birgerjohansson/Epi/Images/epi_face_instagram_large.png

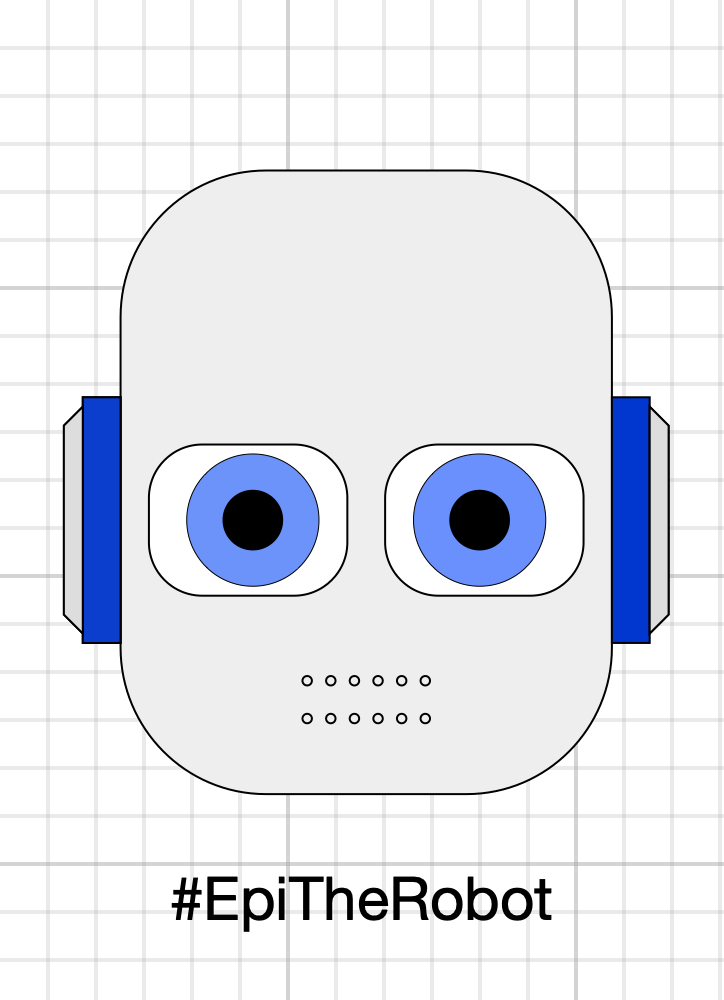
Images/epi_face_instagram_large.png
