birgerjohansson/Epi/Images/EpiArmsCrossed.jpg

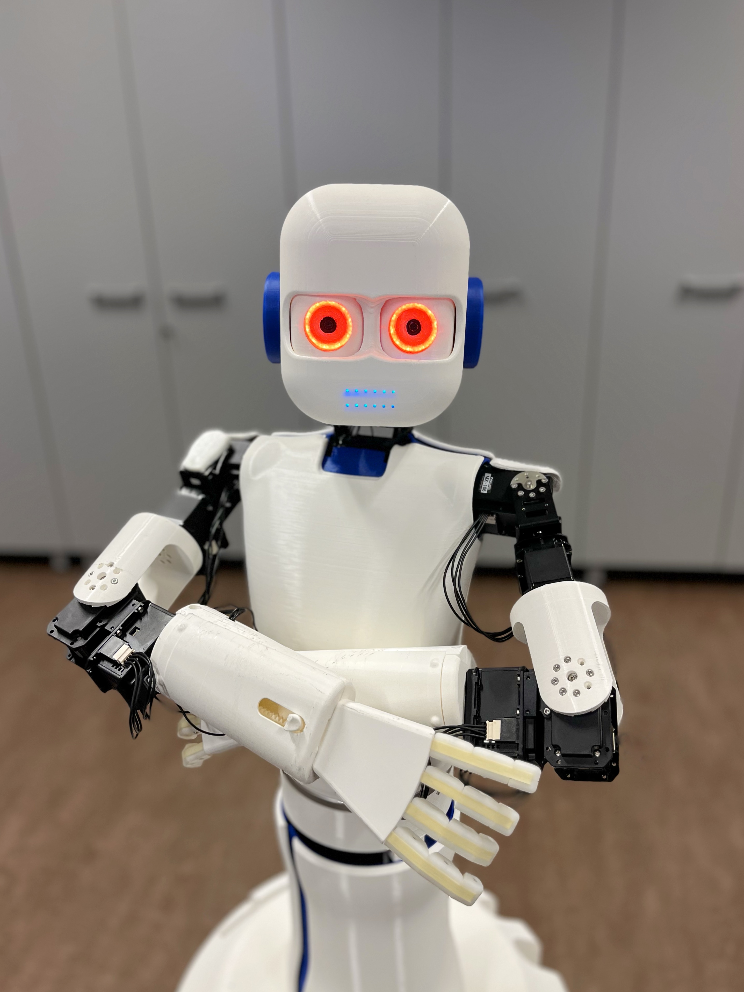
Images/EpiArmsCrossed.jpg
