birgerjohansson/Epi/Images/EpiBall.jpg

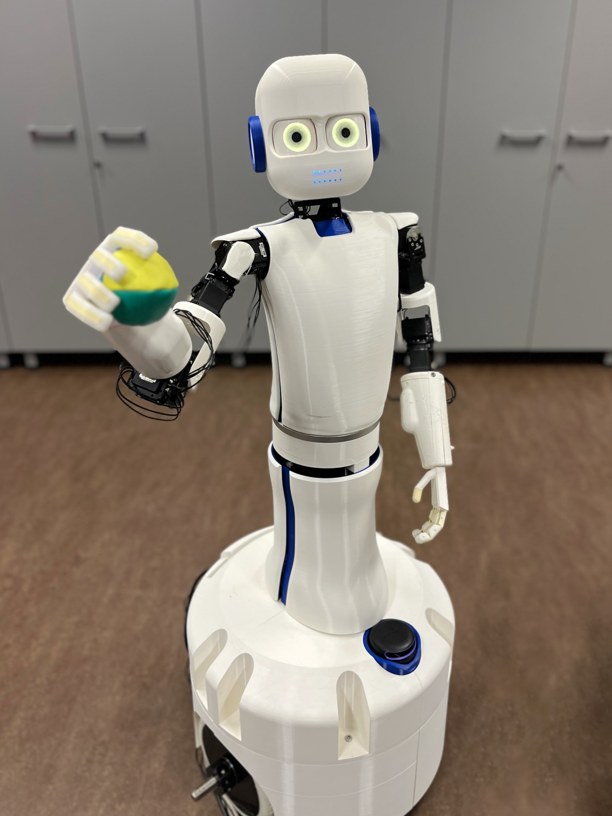
Images/EpiBall.jpg
