birgerjohansson/Epi/Images/EpiHandshake.jpg

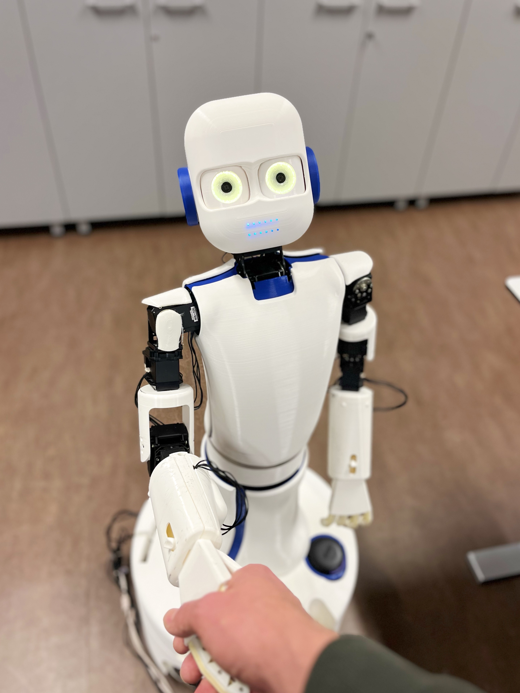
Images/EpiHandshake.jpg
