birgerjohansson/Epi/Images/EpiHoldingDuck.jpg

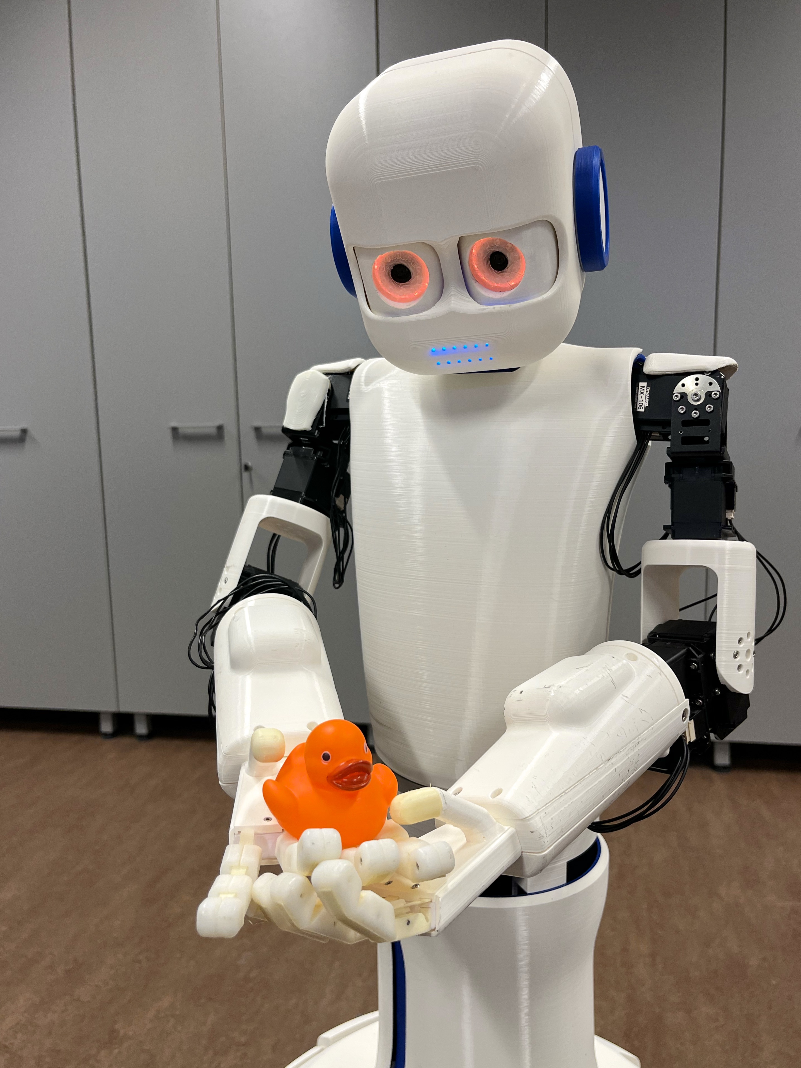
Images/EpiHoldingDuck.jpg
