birgerjohansson/Epi/Images/EpiLookingAtDuck.jpg

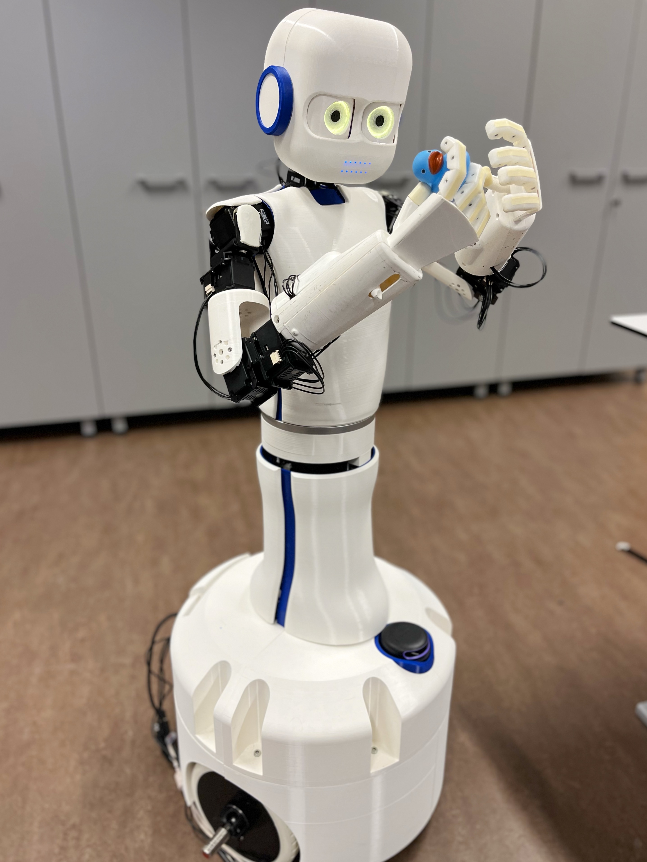
Images/EpiLookingAtDuck.jpg
