birgerjohansson/Epi/Images/EpiTorso.jpg

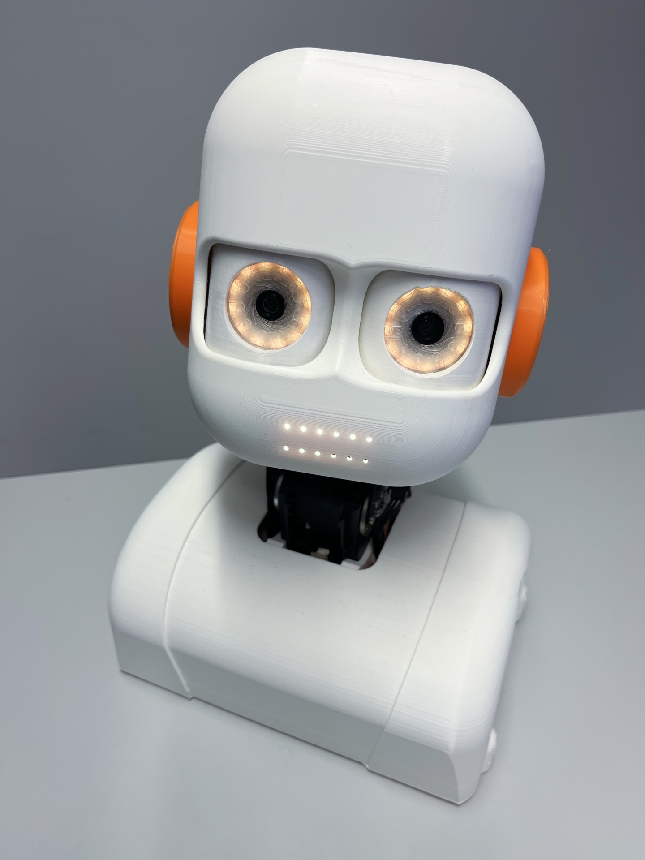
Images/EpiTorso.jpg
