birgerjohansson/Epi/Images/EpiTorso/1.jpg

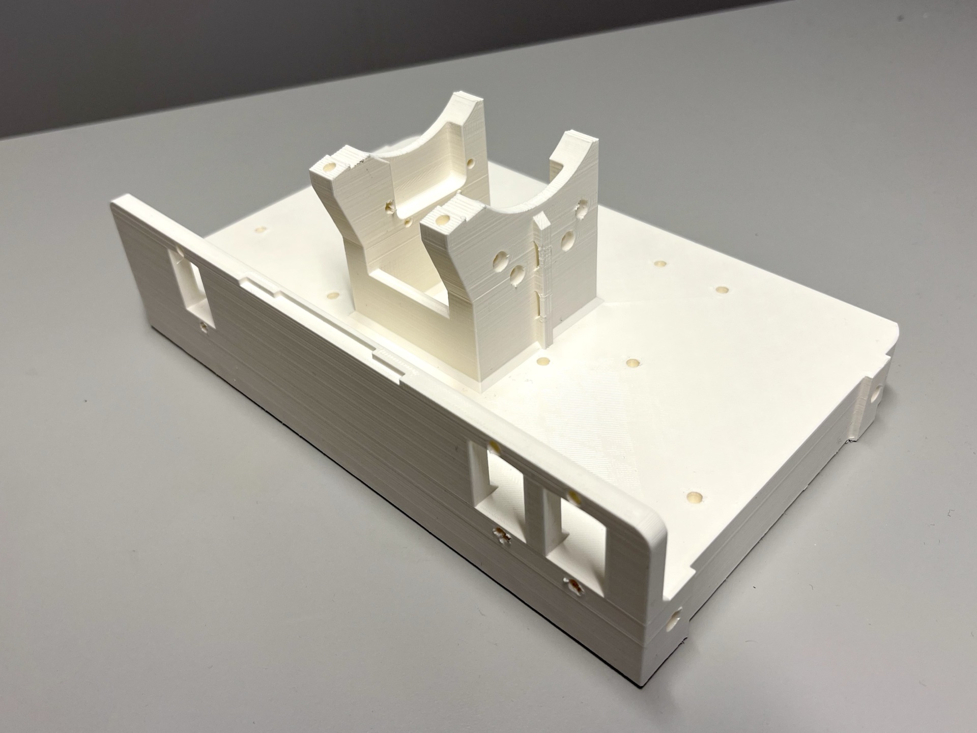
Images/EpiTorso/1.jpg
