birgerjohansson/Epi/Images/EpiTorso/2.jpg

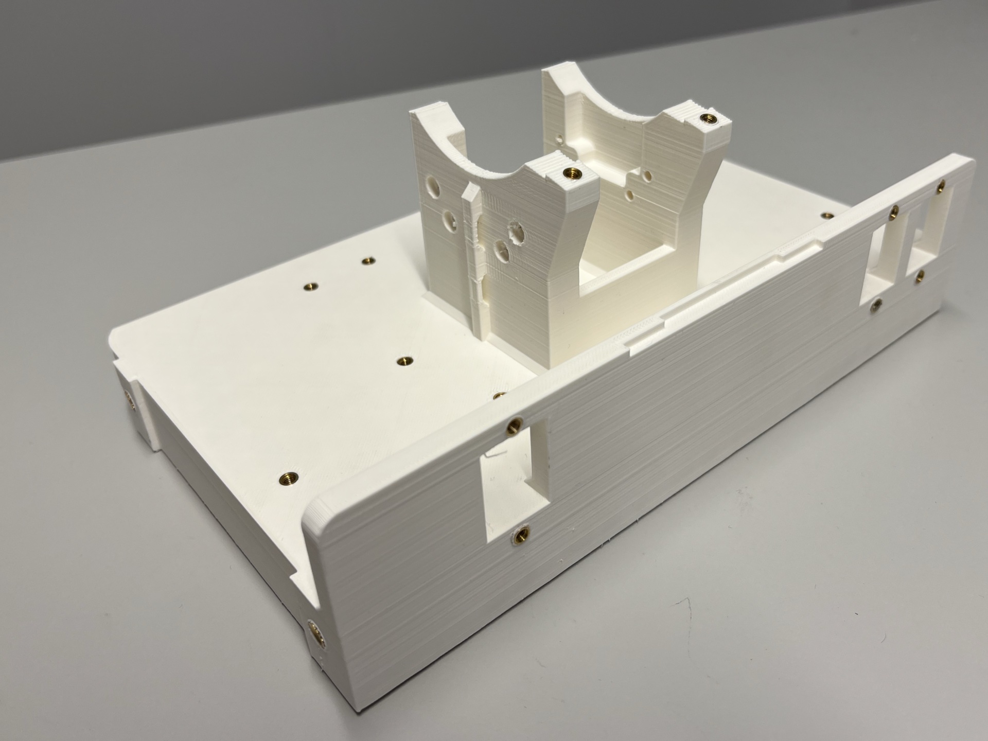
Images/EpiTorso/2.jpg
