birgerjohansson/Epi/Images/EpiTorso/3.jpg

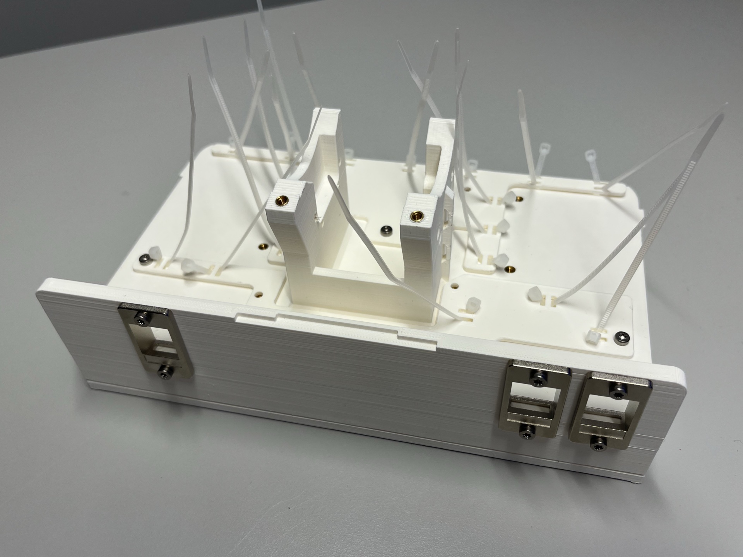
Images/EpiTorso/3.jpg
