birgerjohansson/Epi/Images/EpiTorso/4.jpg

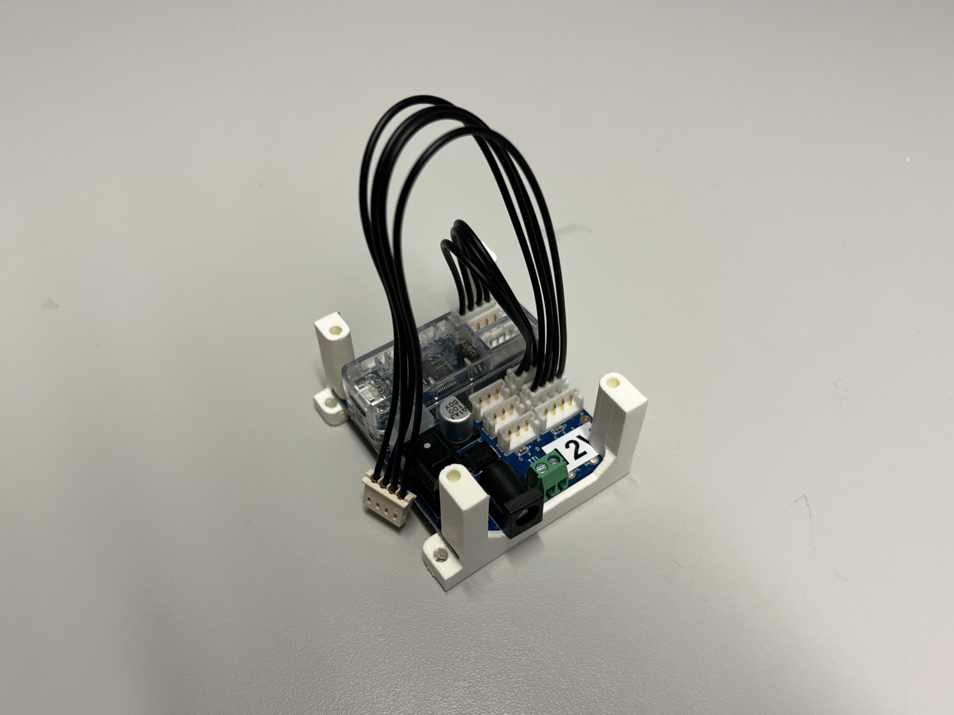
Images/EpiTorso/4.jpg
