birgerjohansson/Epi/Images/EpiTorso/5.jpg

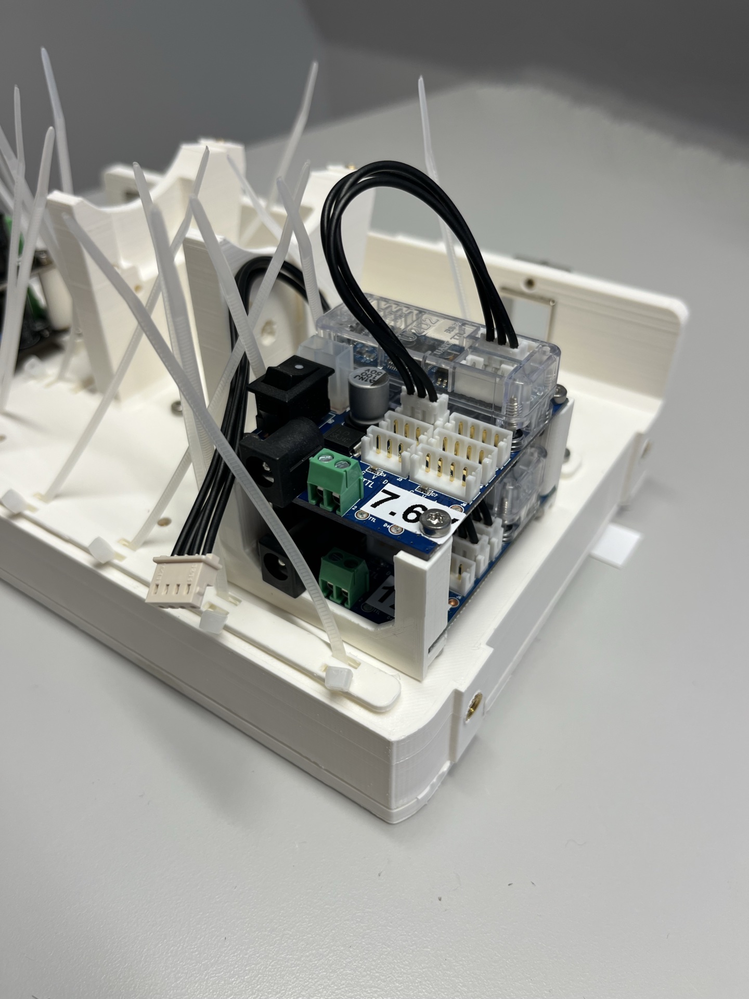
Images/EpiTorso/5.jpg
