birgerjohansson/Epi/Images/EpiTorso/6.jpg

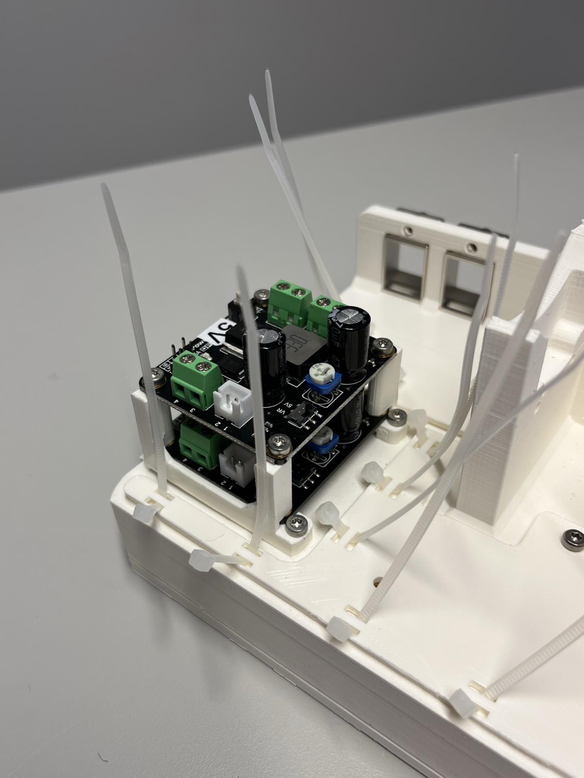
Images/EpiTorso/6.jpg
