birgerjohansson/Epi/Images/EpiTorso/7.jpg

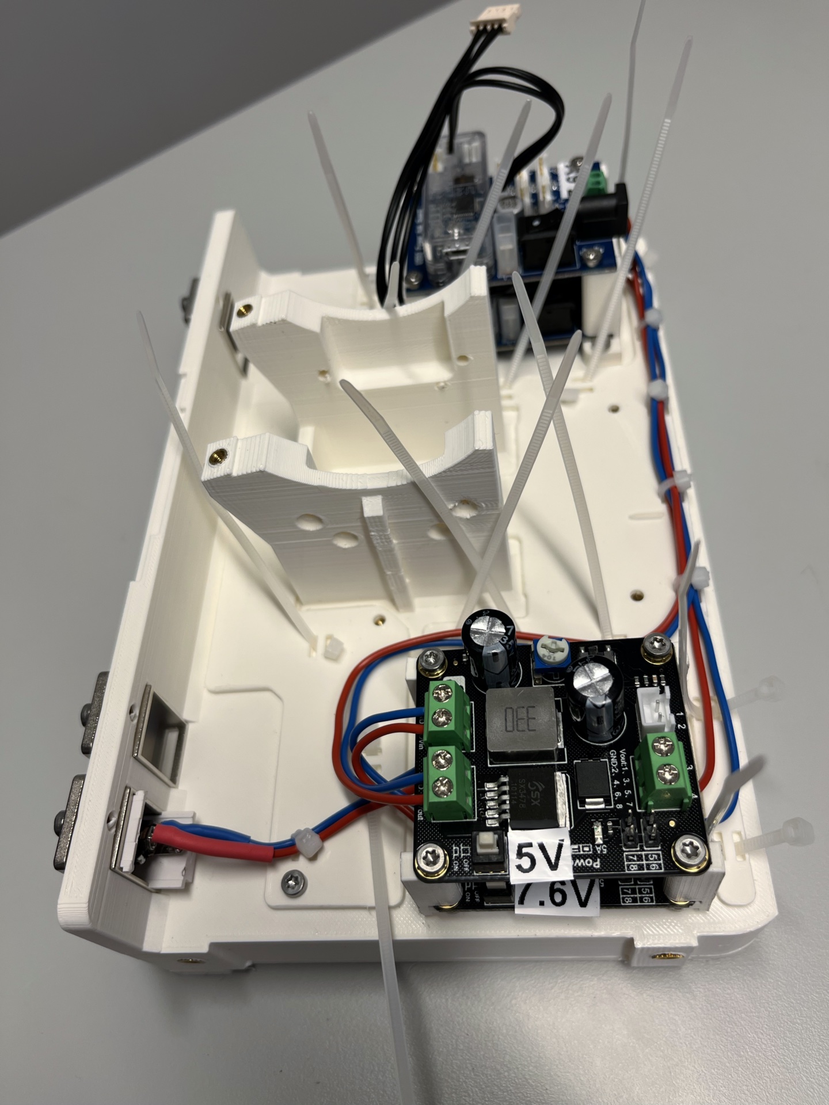
Images/EpiTorso/7.jpg
