birgerjohansson/Epi/Images/EpiTorso/8.jpg

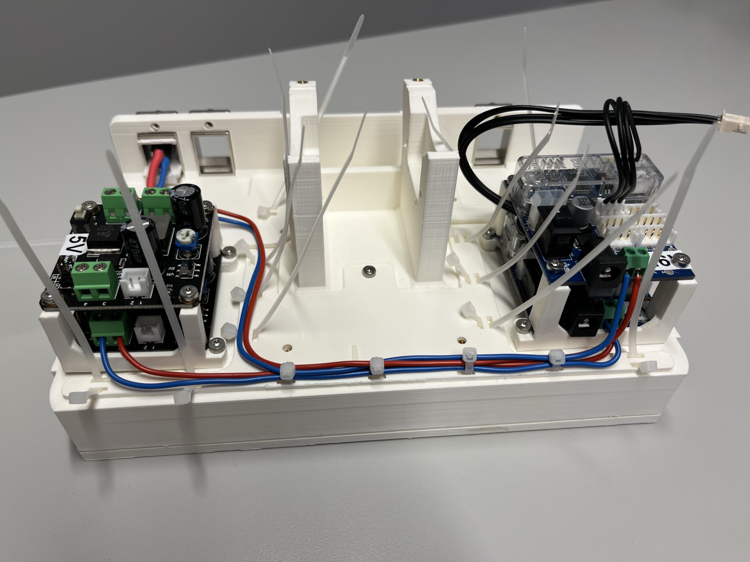
Images/EpiTorso/8.jpg
