birgerjohansson/Epi/Images/EpiTorso/9.jpg

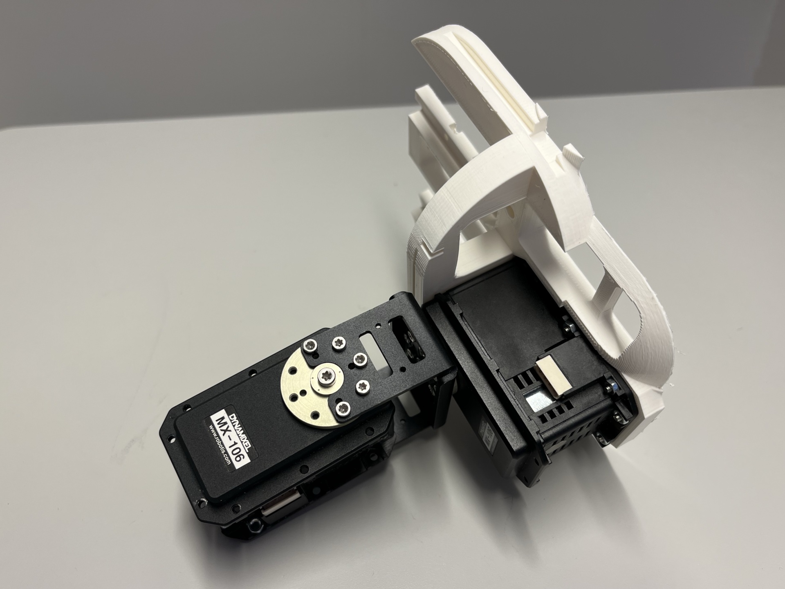
Images/EpiTorso/9.jpg
