birgerjohansson/Epi/Images/EpiTorso/10.jpg

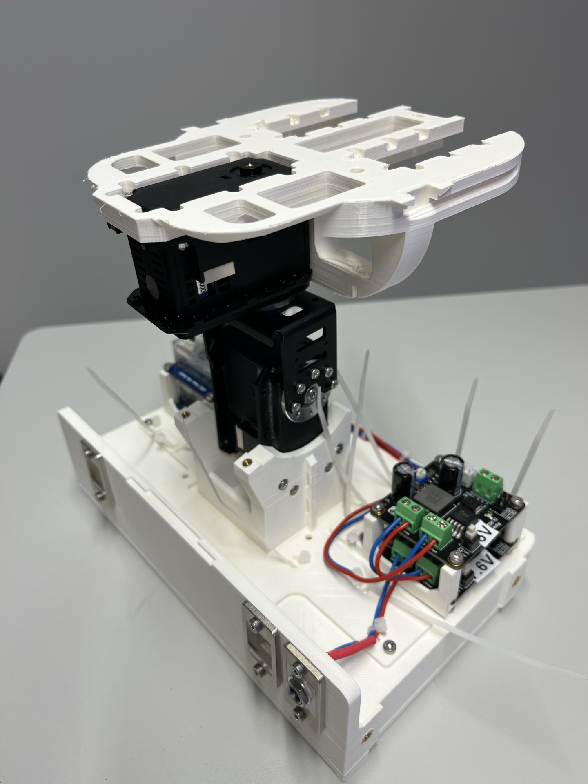
Images/EpiTorso/10.jpg
