birgerjohansson/Epi/Images/EpiTorso/11.jpg

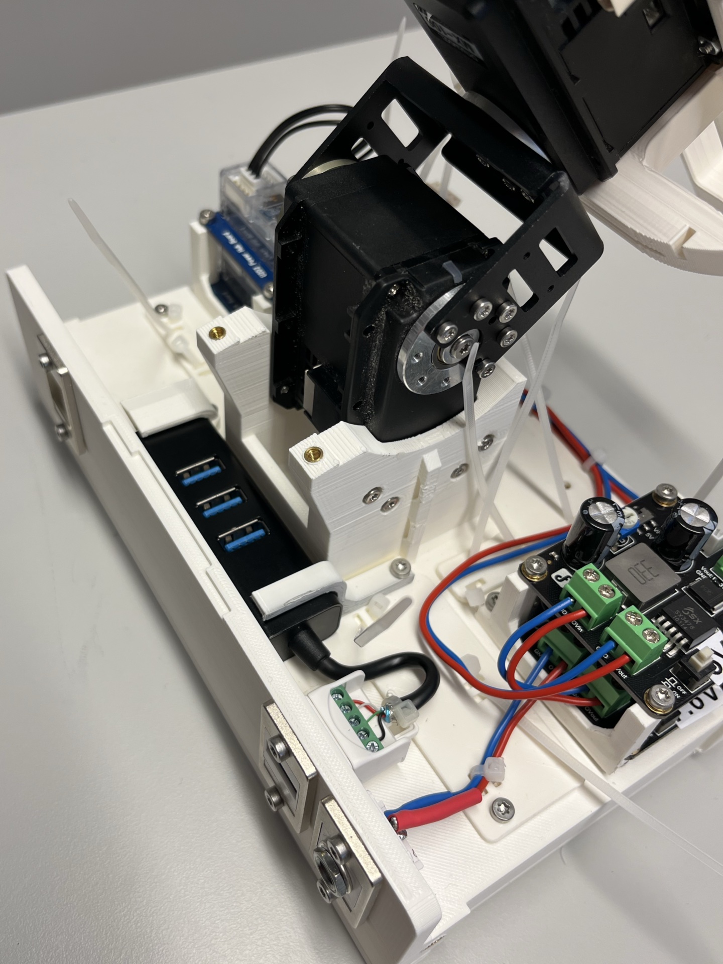
Images/EpiTorso/11.jpg
