birgerjohansson/Epi/Images/EpiTorso/12.jpg

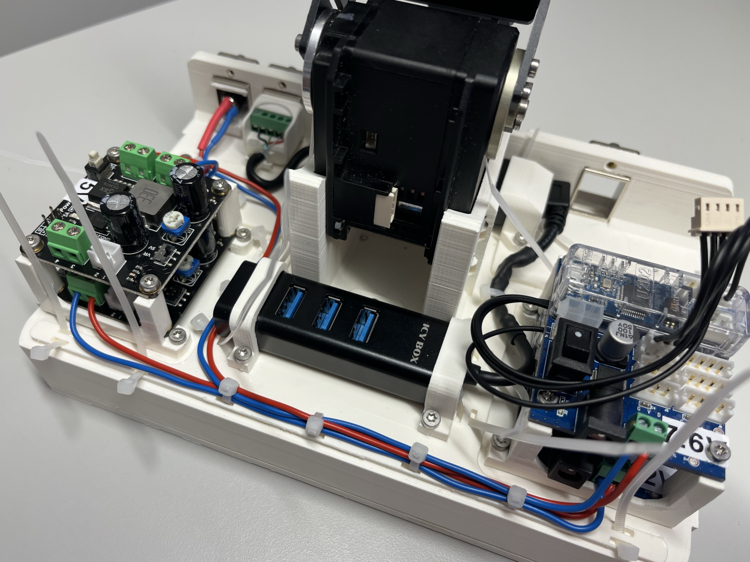
Images/EpiTorso/12.jpg
