birgerjohansson/Epi/Images/EpiTorso/13.jpg

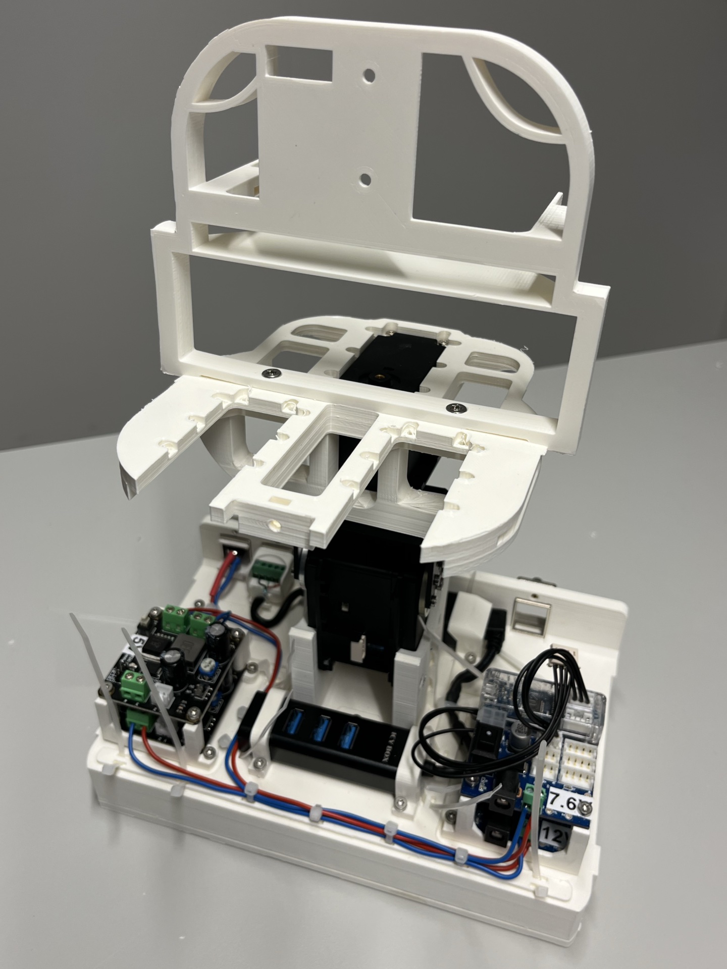
Images/EpiTorso/13.jpg
