birgerjohansson/Epi/Images/EpiTorso/14.jpg

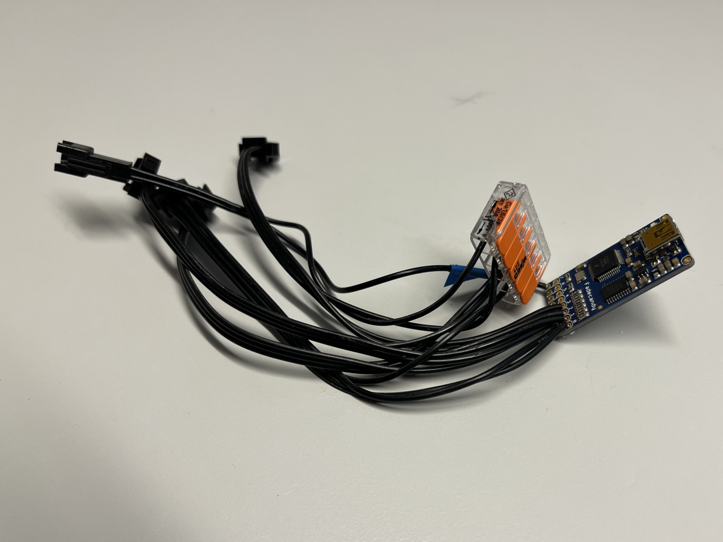
Images/EpiTorso/14.jpg
