birgerjohansson/Epi/Images/EpiTorso/15.jpg

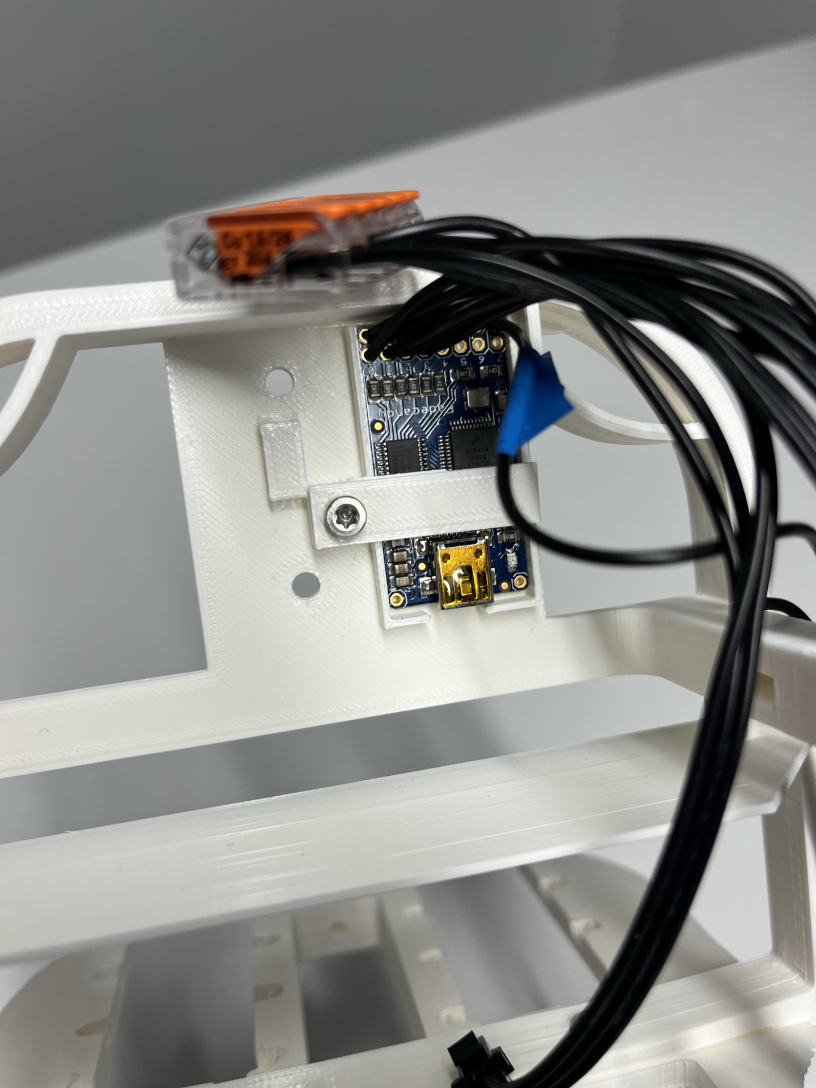
Images/EpiTorso/15.jpg
