birgerjohansson/Epi/Images/EpiTorso/16.jpg

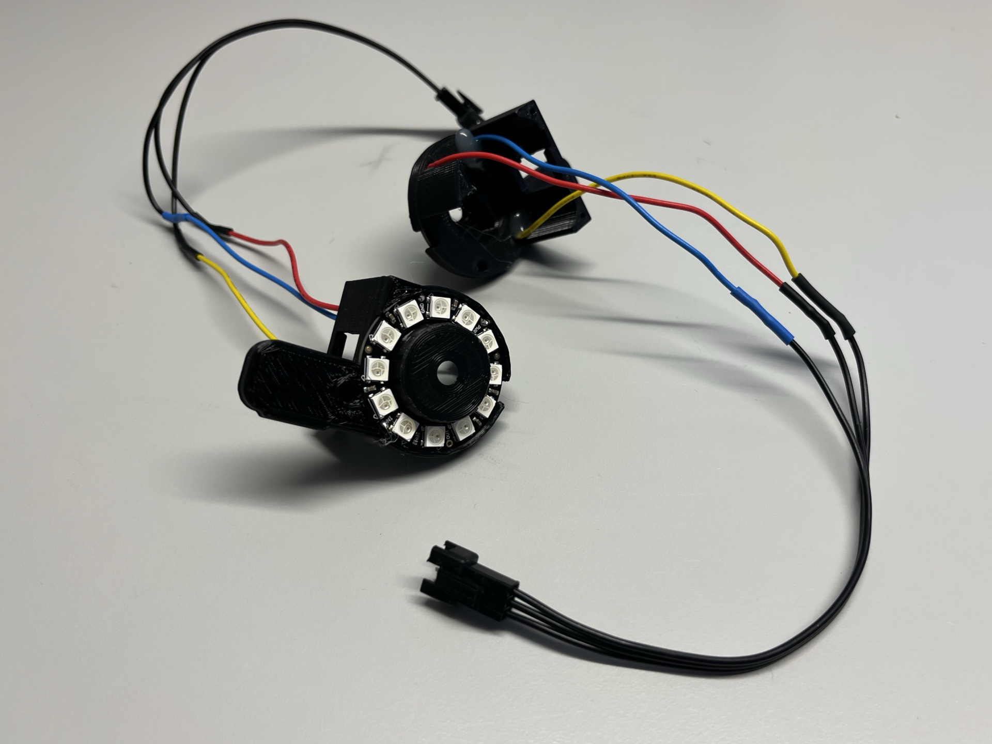
Images/EpiTorso/16.jpg
