birgerjohansson/Epi/Images/EpiTorso/17.jpg

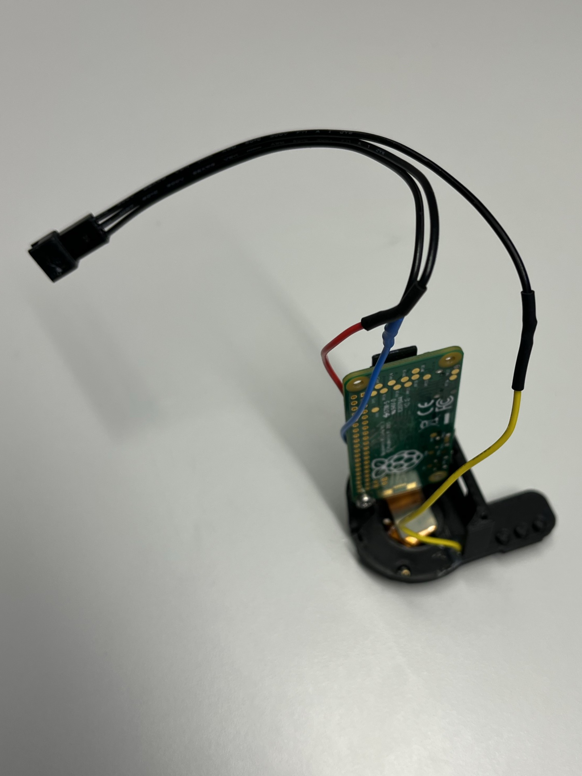
Images/EpiTorso/17.jpg
