birgerjohansson/Epi/Images/EpiTorso/18.jpg

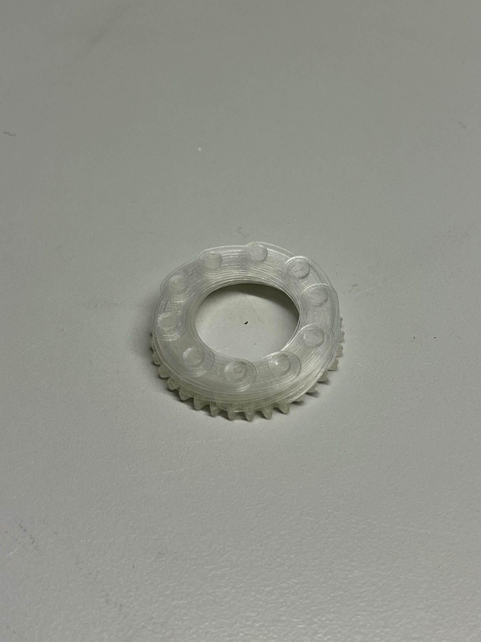
Images/EpiTorso/18.jpg
