birgerjohansson/Epi/Images/EpiTorso/19.jpg

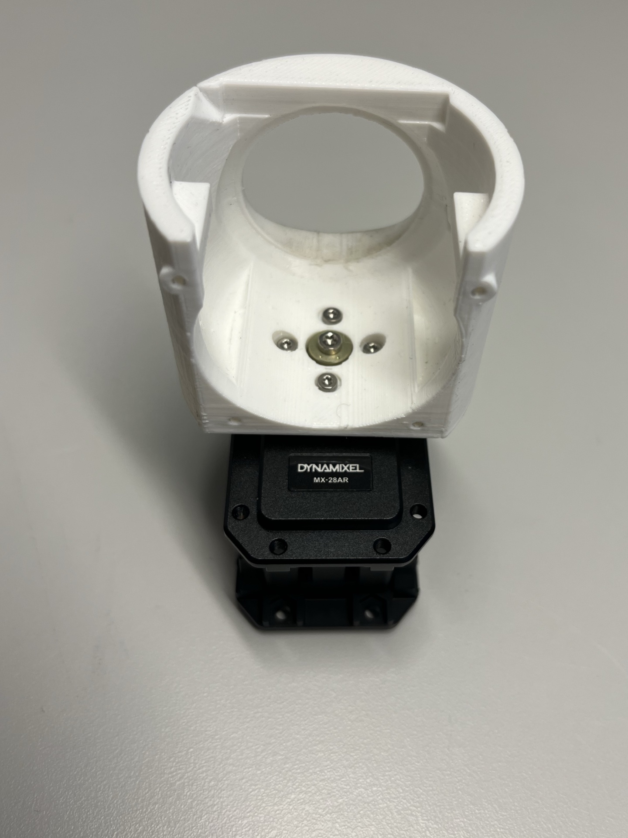
Images/EpiTorso/19.jpg
