birgerjohansson/Epi/Images/EpiTorso/20.jpg

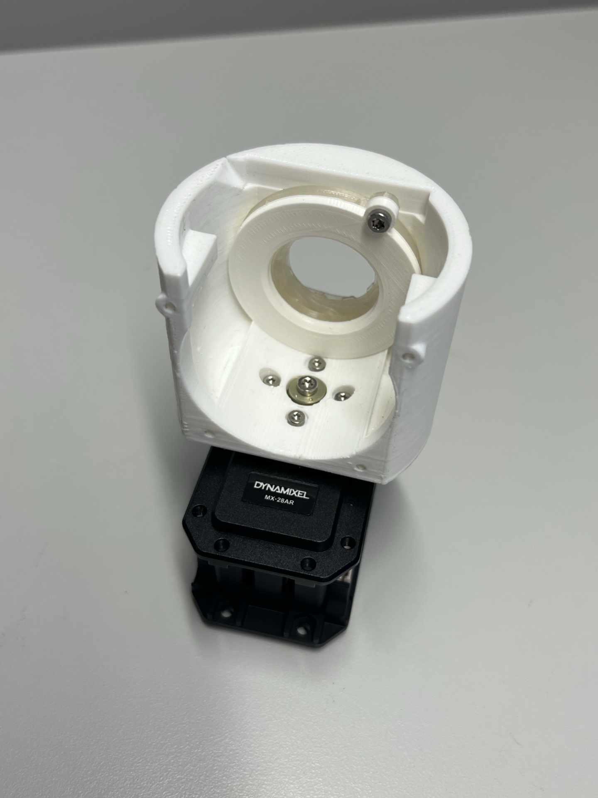
Images/EpiTorso/20.jpg
