birgerjohansson/Epi/Images/EpiTorso/21.jpg

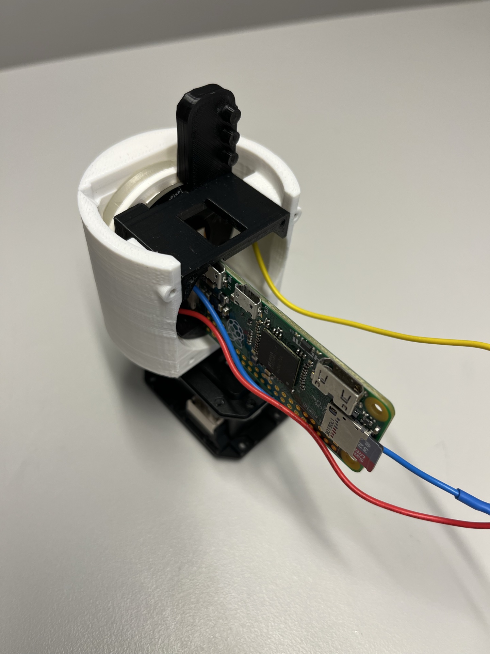
Images/EpiTorso/21.jpg
