birgerjohansson/Epi/Images/EpiTorso/22.jpg

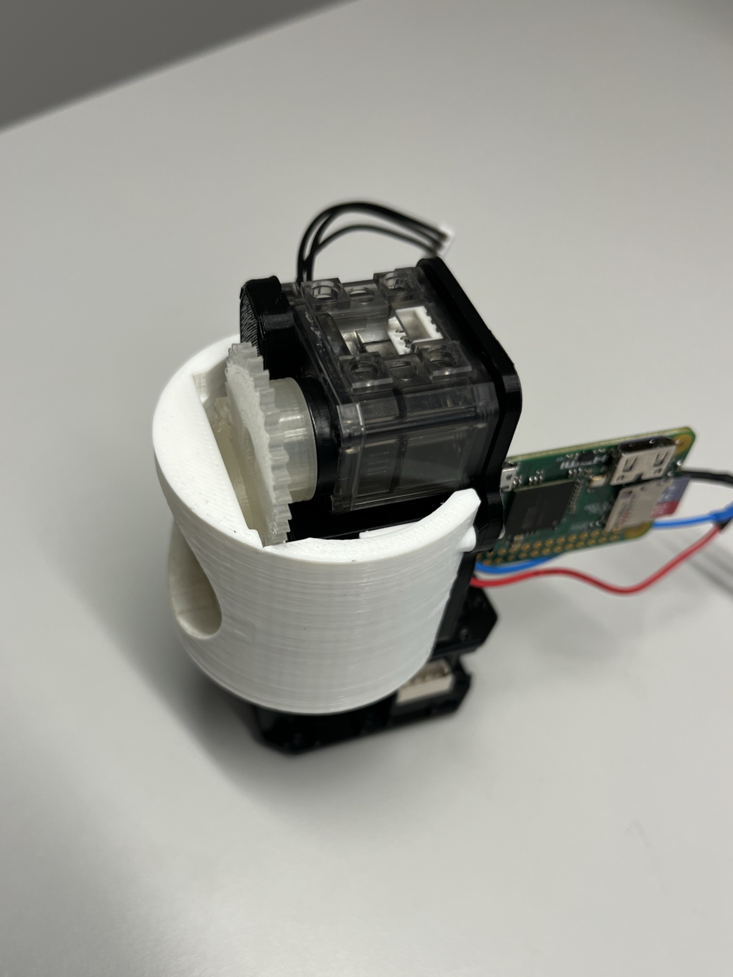
Images/EpiTorso/22.jpg
