birgerjohansson/Epi/Images/EpiTorso/23.jpg

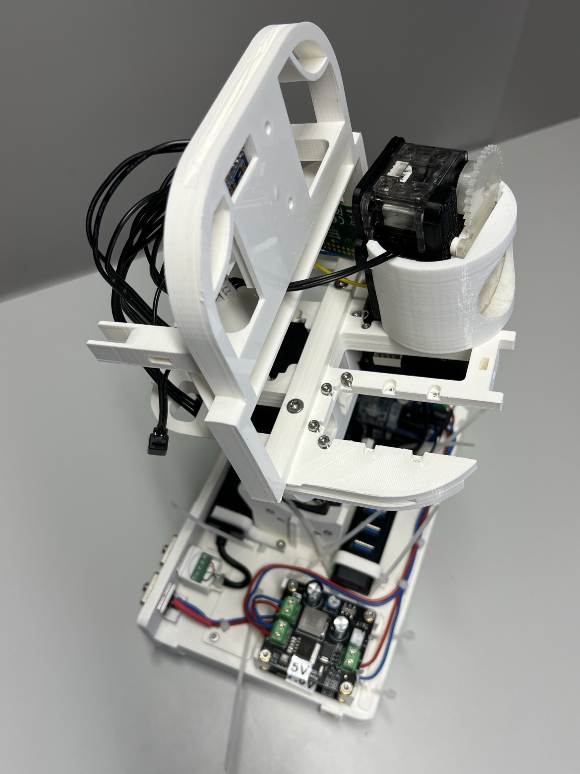
Images/EpiTorso/23.jpg
