birgerjohansson/Epi/Images/EpiTorso/24.jpg

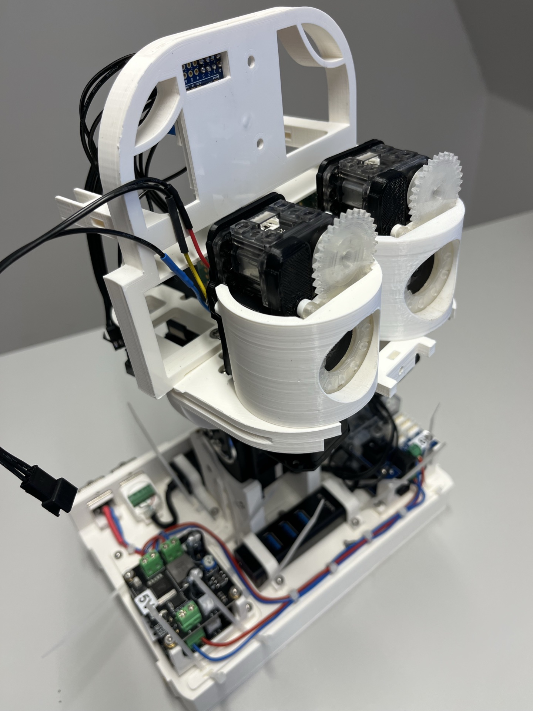
Images/EpiTorso/24.jpg
