birgerjohansson/Epi/Images/EpiTorso/25.jpg

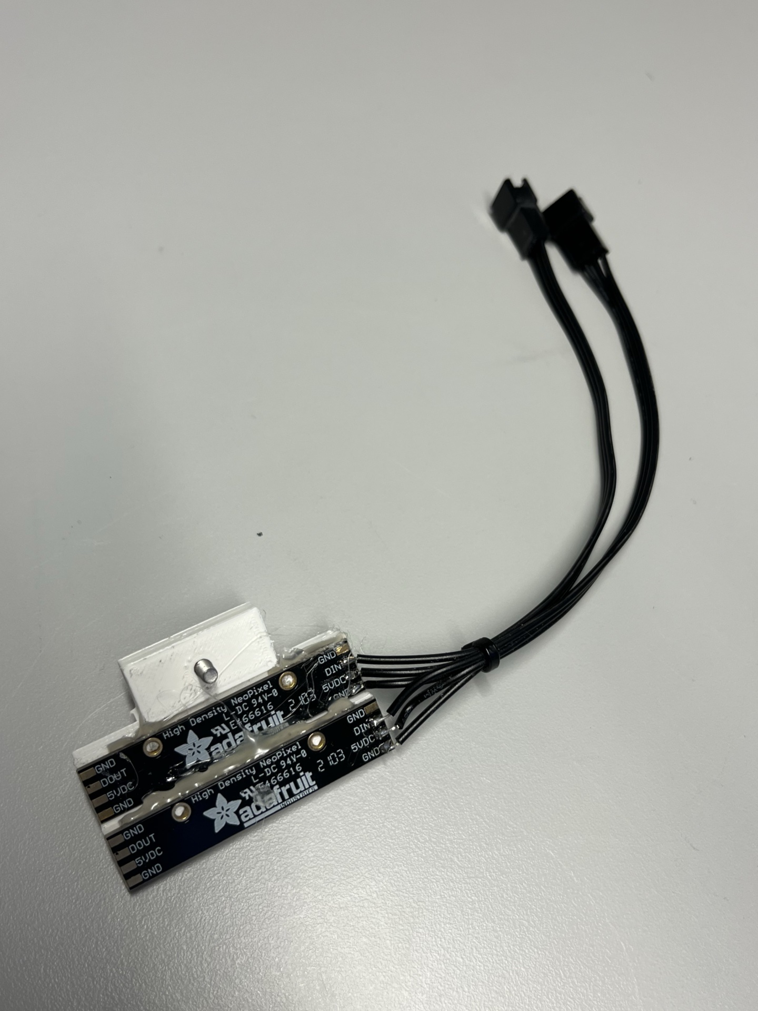
Images/EpiTorso/25.jpg
