birgerjohansson/Epi/Images/EpiTorso/26.jpg

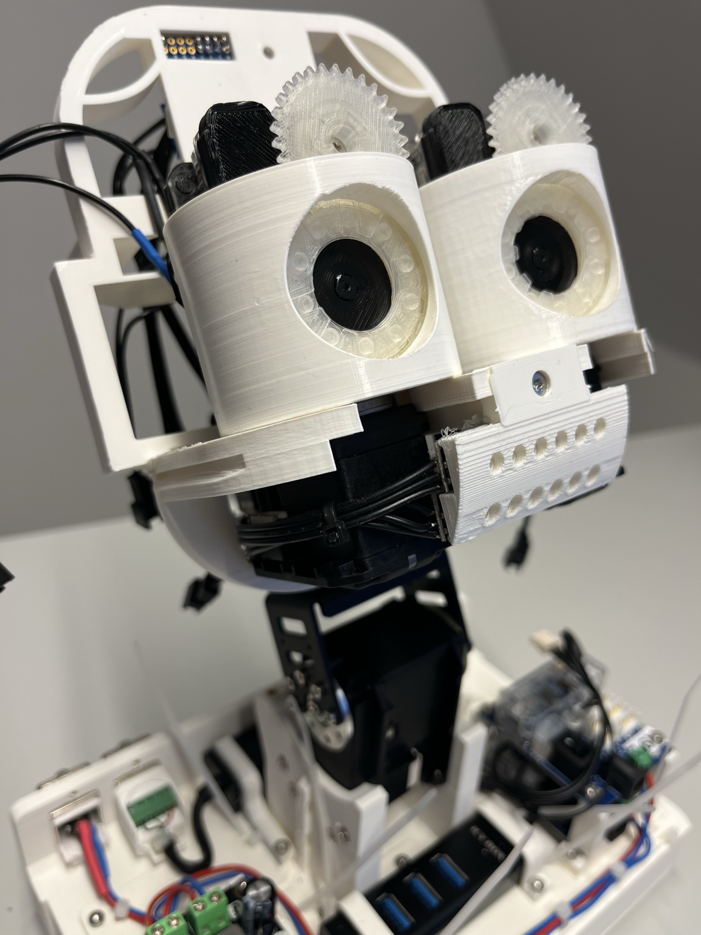
Images/EpiTorso/26.jpg
