birgerjohansson/Epi/Images/EpiTorso/27.jpg

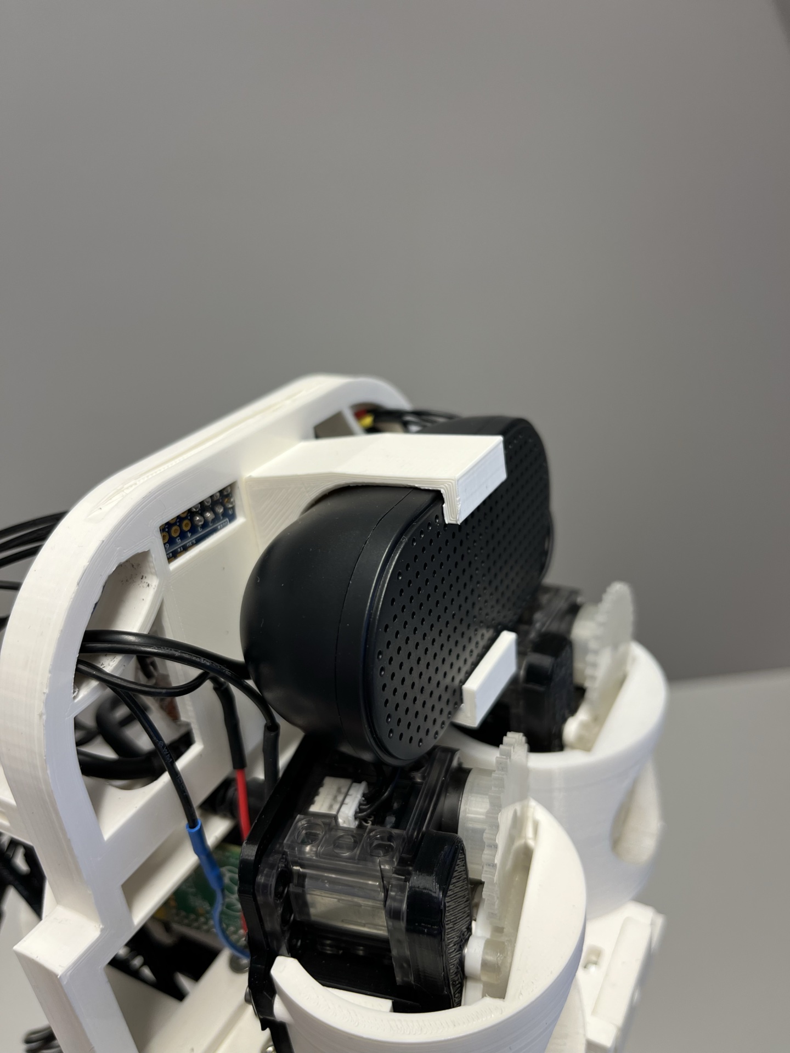
Images/EpiTorso/27.jpg
