birgerjohansson/Epi/Images/EpiTorso/28.jpg

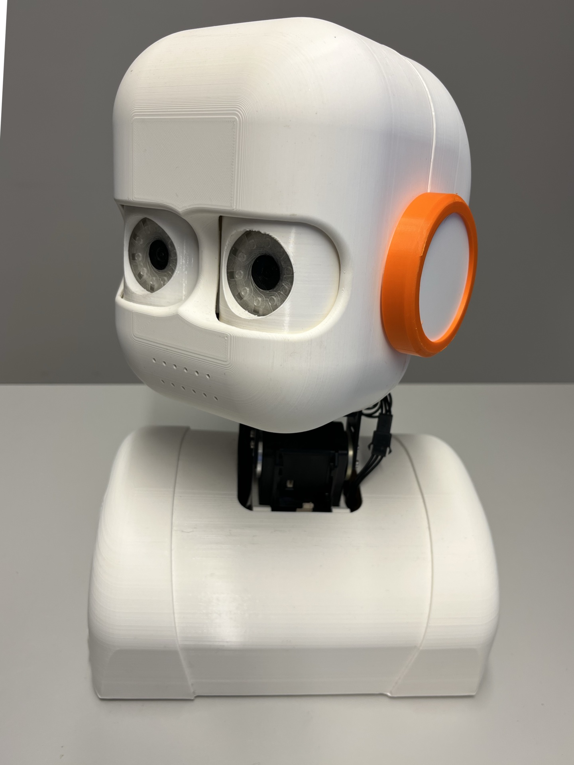
Images/EpiTorso/28.jpg
