birgerjohansson/Epi/Images/EpiTorso/EpiTorsoCablesBack.jpg

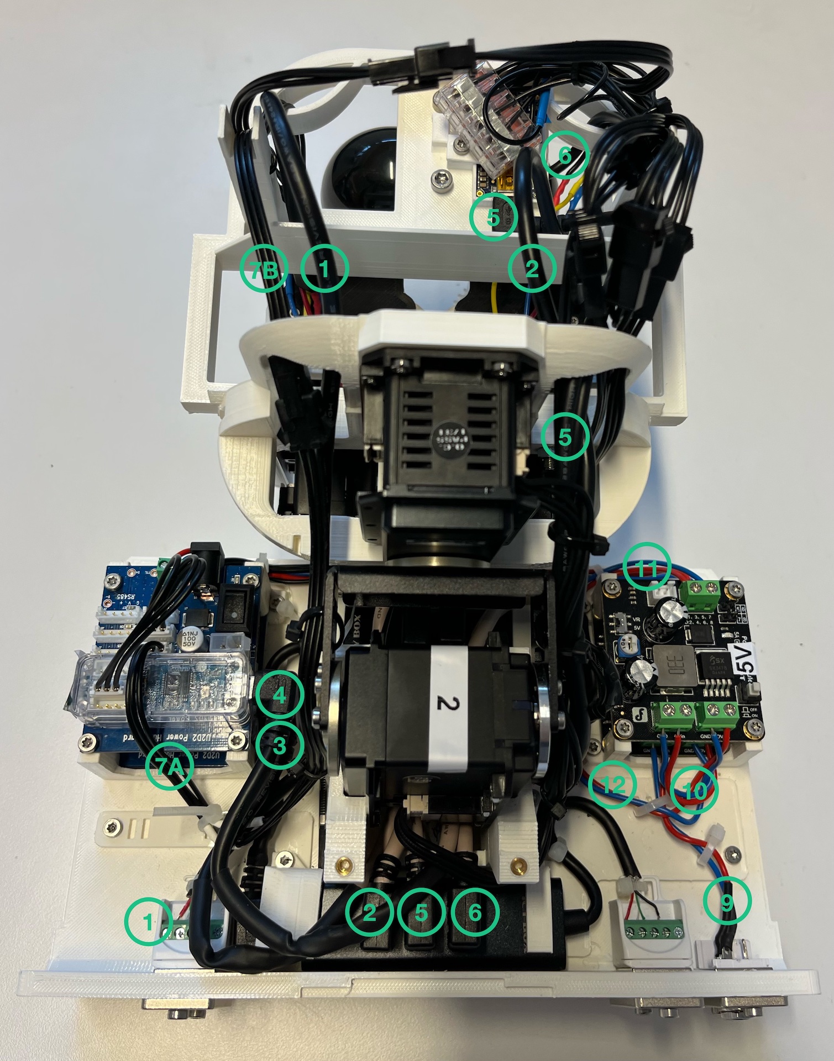
Images/EpiTorso/EpiTorsoCablesBack.jpg
