birgerjohansson/Epi/Images/EpiTorso/EpiTorsoCablesFront.jpg

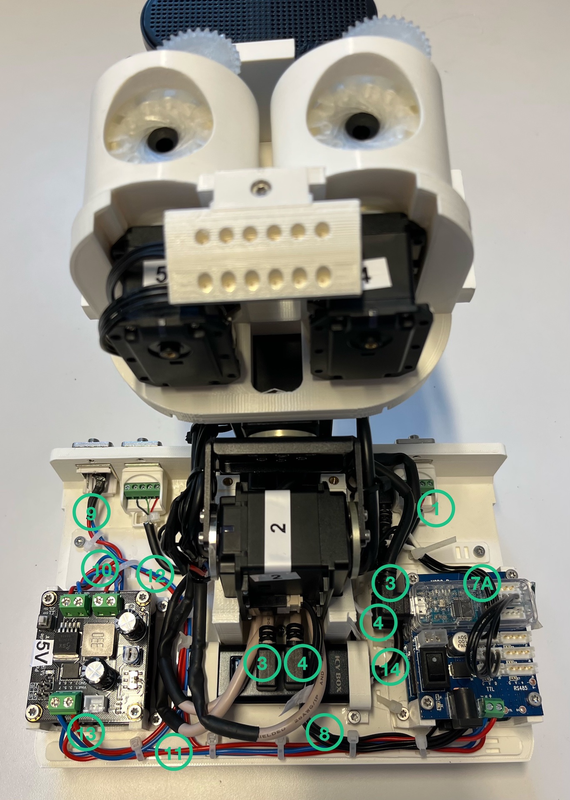
Images/EpiTorso/EpiTorsoCablesFront.jpg
