birgerjohansson/Epi/Images/EpiTorso/EpiTorsoConnectors.png

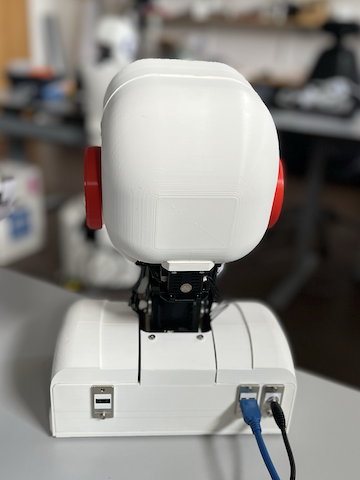
Images/EpiTorso/EpiTorsoConnectors.png
