birgerjohansson/Epi/Images/Safari_Ikaros.png

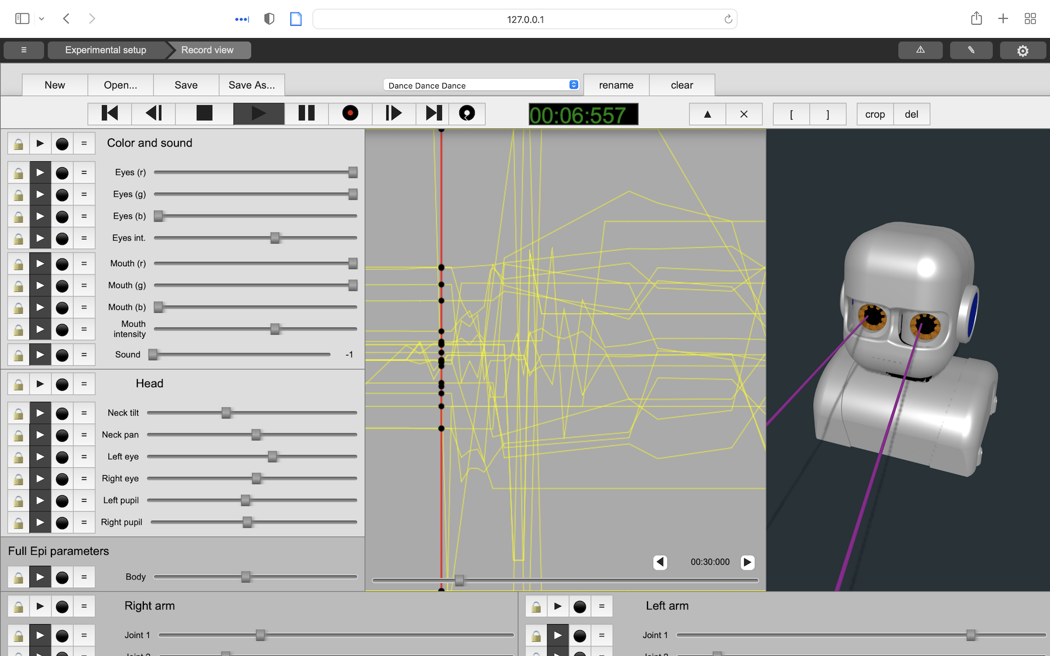
Images/Safari_Ikaros.png
