birgerjohansson/Epi/Images/Terminal_Ikaros.png

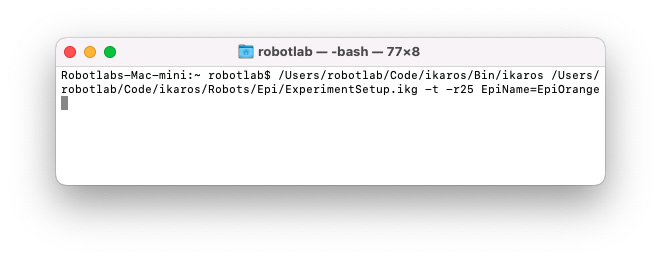
Images/Terminal_Ikaros.png
