birgerjohansson/Epi/Images/two_epis.jpeg

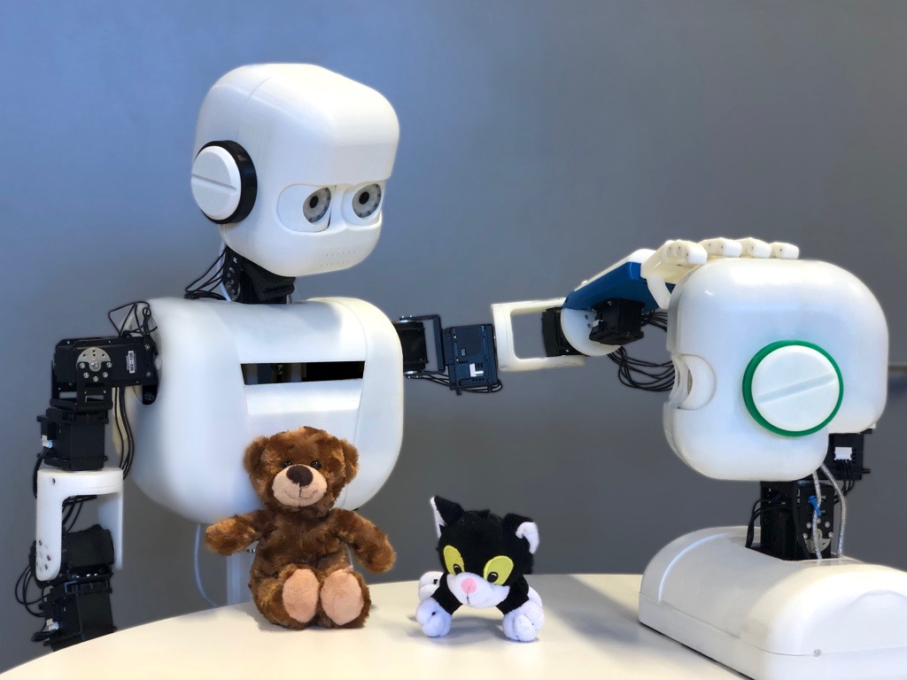
Images/two_epis.jpeg
