birgerjohansson/Epi/Images/two_torso_epis.jpeg

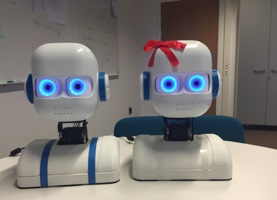
Images/two_torso_epis.jpeg
