birgerjohansson/Epi/Models/EpiKeyring/Epi_singleColorKeyring.jpg

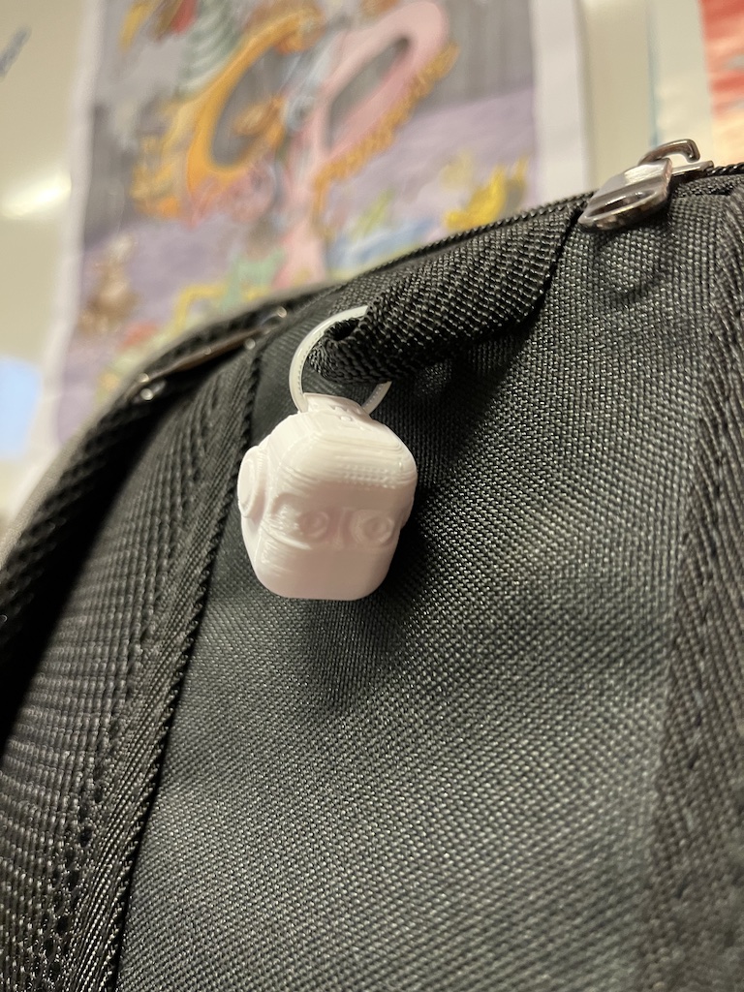
Models/EpiKeyring/Epi_singleColorKeyring.jpg
