birgerjohansson/Epi/Models/EpiKeyring/Epi_twoColorKeyring.jpg

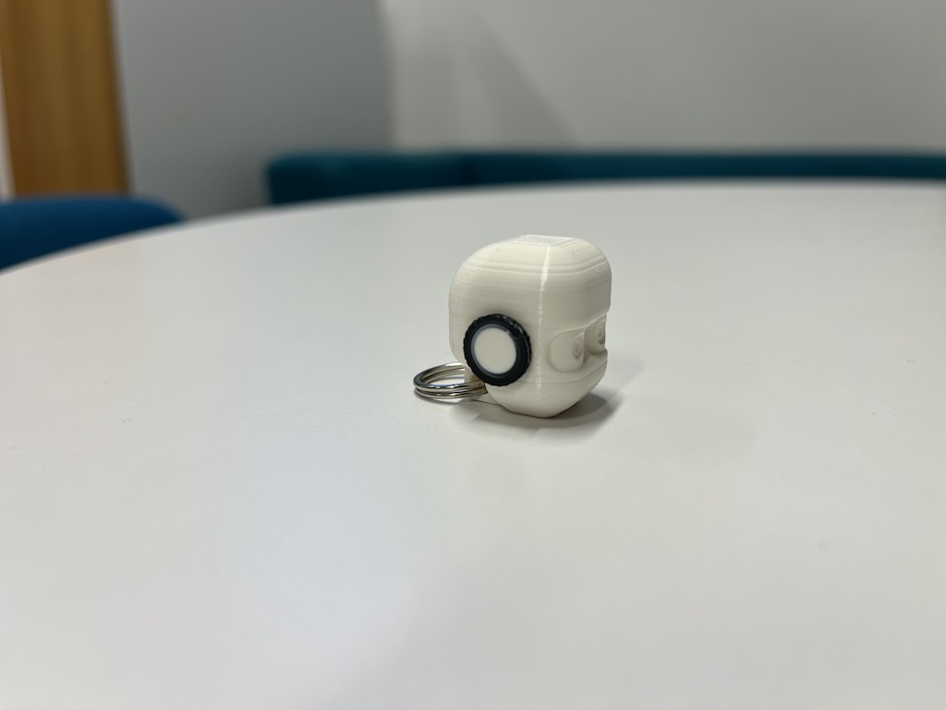
Models/EpiKeyring/Epi_twoColorKeyring.jpg
