birgerjohansson/Epi/Images/EpiTorso/EpiEyePlasticParts.jpg

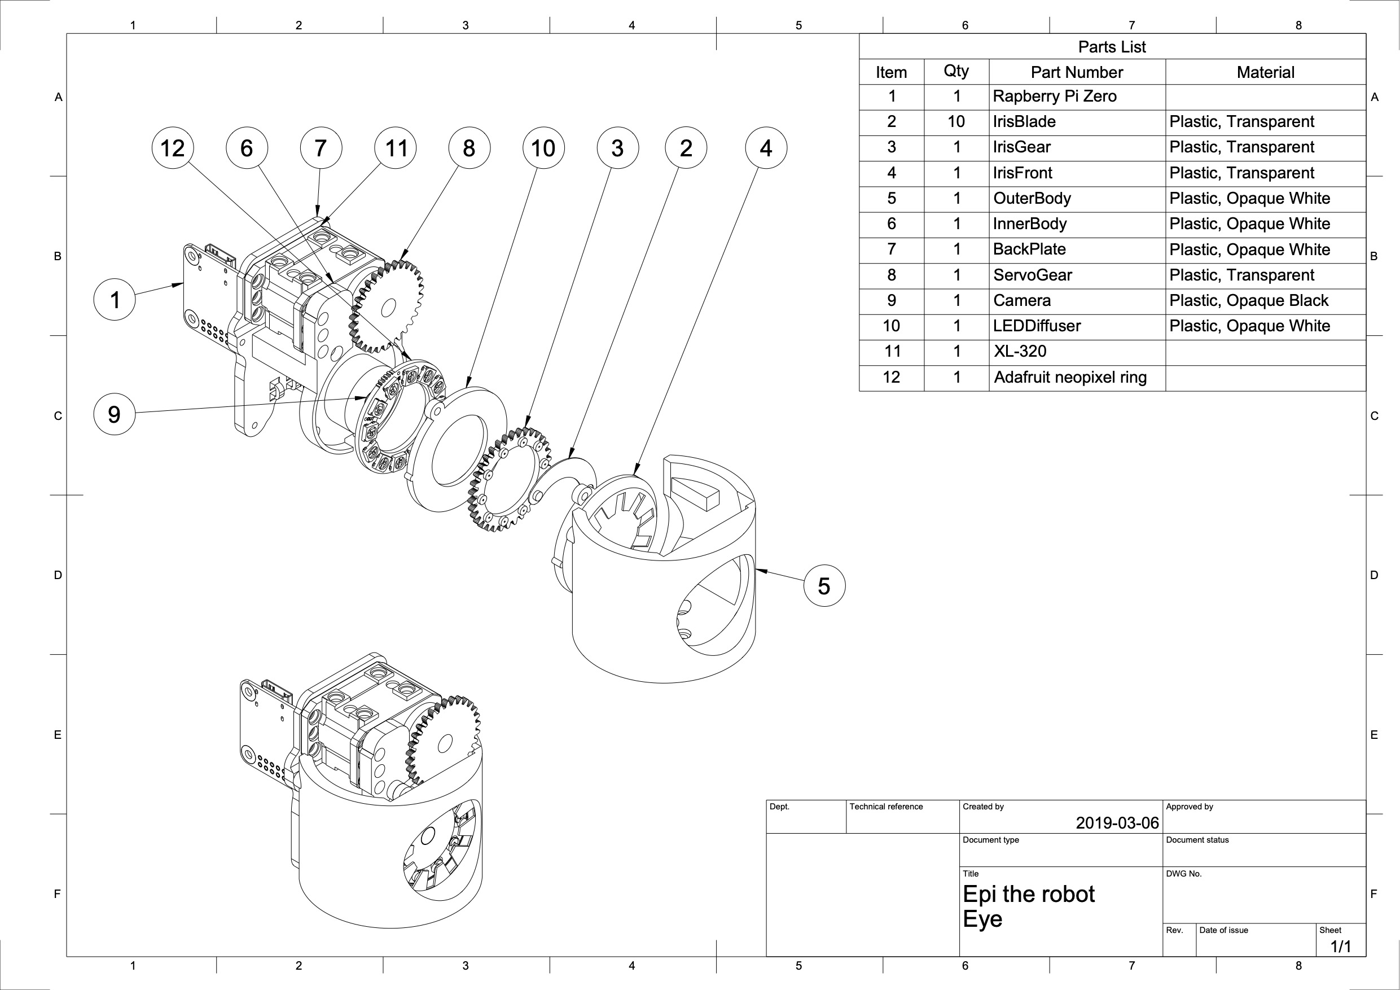
Images/EpiTorso/EpiEyePlasticParts.jpg
