birgerjohansson/Epi/Images/EpiTorso/EpiTorsoPlasticParts.jpg

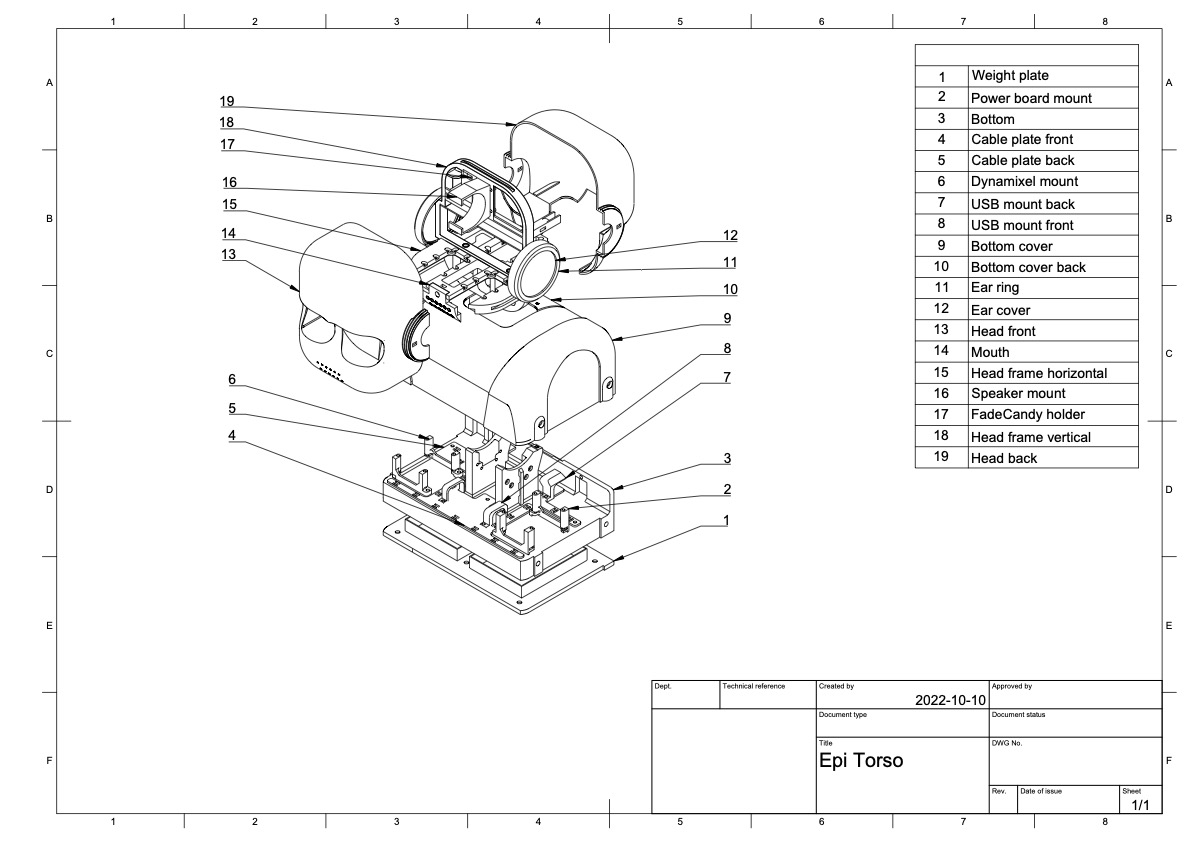
Images/EpiTorso/EpiTorsoPlasticParts.jpg
