birgerjohansson/Epi/Models/Epi/Arm/Left/Top.step

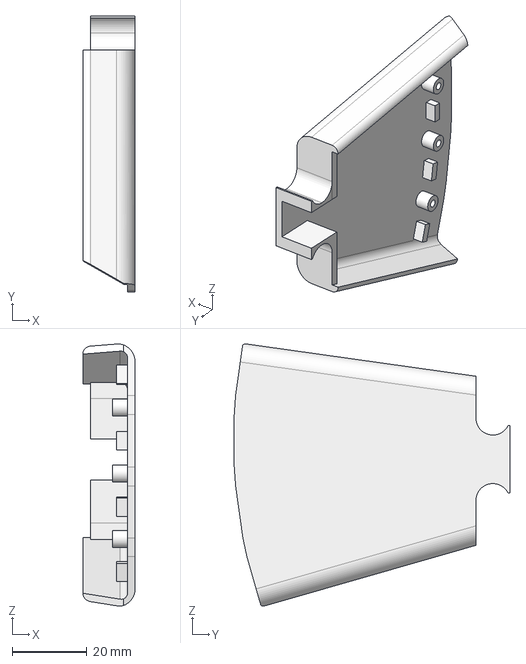
[picture p49: CAD file, 2019-03-13]
Models/Epi/Arm/Left/Top.step
14.0 x 73.7 x 70.1 mm
