birgerjohansson/Epi/Models/Epi/Arm/LowerArm2.step

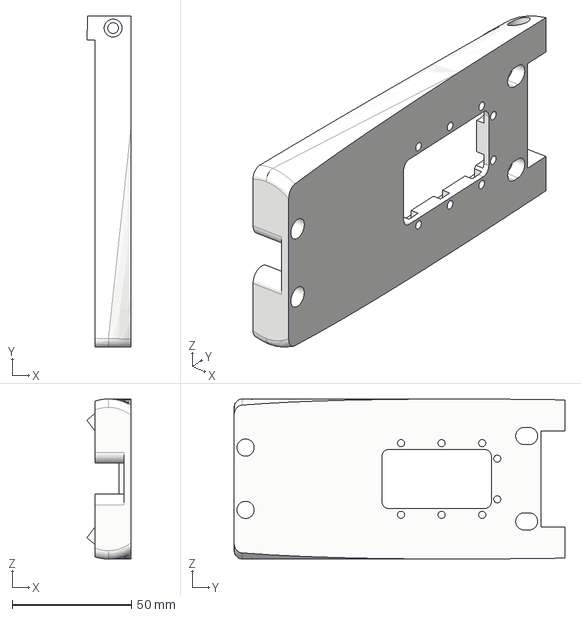
[picture p50: CAD file, 2019-03-13]
Models/Epi/Arm/LowerArm2.step
18.4 x 138.5 x 67.0 mm
