birgerjohansson/Epi/Models/Epi/Arm/Right/FingerMount.step

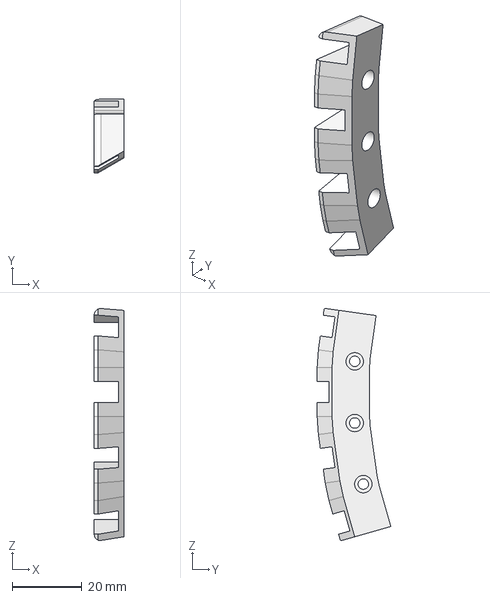
[picture p51: CAD file, 2019-03-13]
Models/Epi/Arm/Right/FingerMount.step
8.50 x 21.1 x 66.4 mm
