birgerjohansson/Epi/Models/Epi/Head/Eye/OuterBody.step

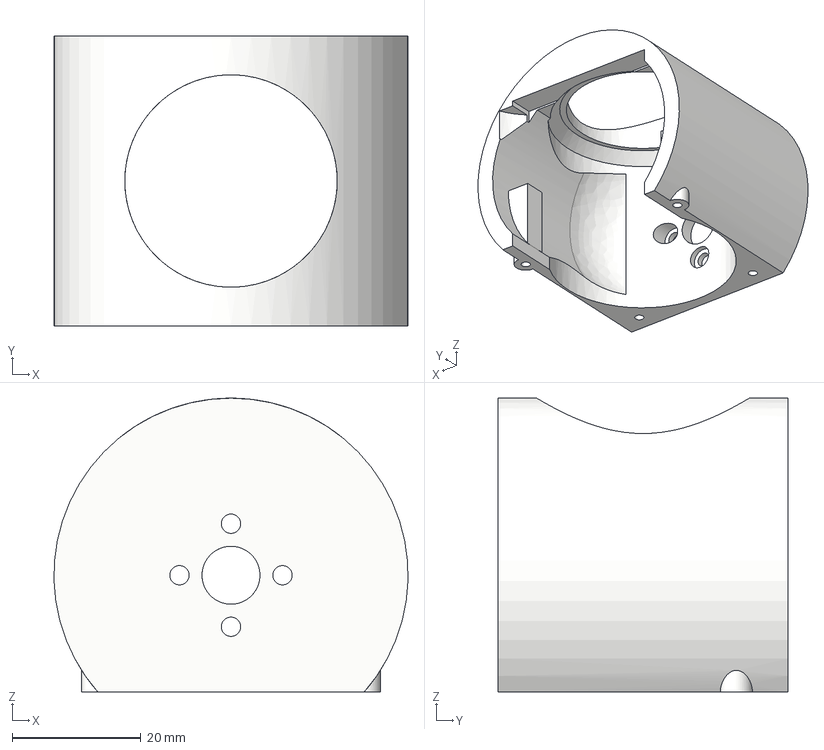
[picture p52: CAD file, 2019-03-13]
Models/Epi/Head/Eye/OuterBody.step
55.0 x 45.0 x 45.6 mm
