birgerjohansson/Epi/Models/Epi/Head/VertcalMount.step

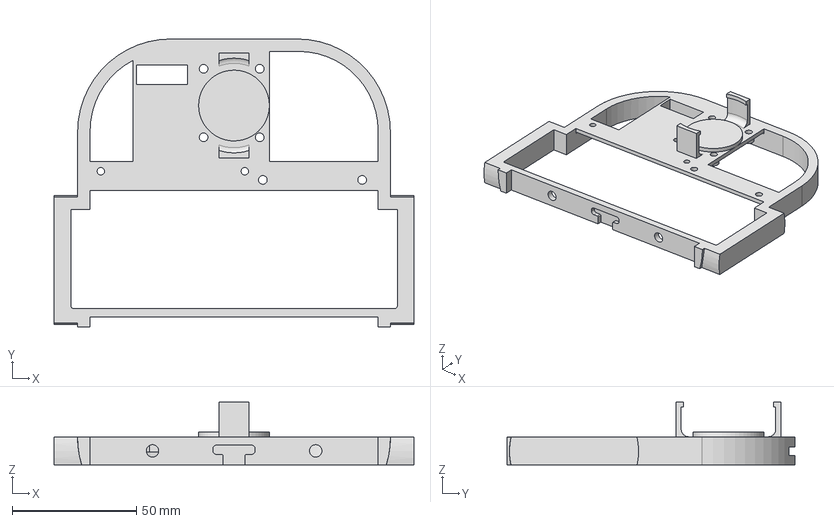
[picture p53: CAD file, 2019-03-13]
Models/Epi/Head/VertcalMount.step
145.0 x 116.0 x 25.4 mm
