birgerjohansson/Epi/Models/EpiKeyring/Epi_twoColorKeyringEarInner.3mf

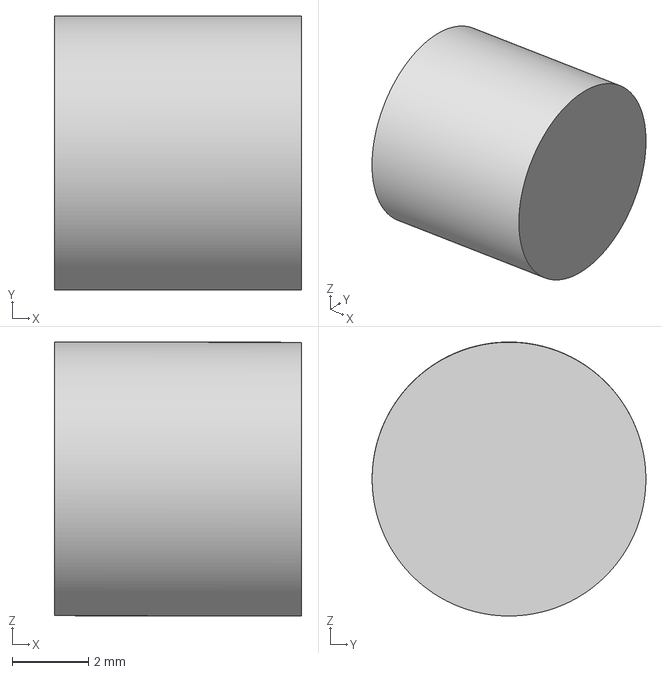
[picture p54: CAD file, 2022-11-29]
Models/EpiKeyring/Epi_twoColorKeyringEarInner.3mf
6.51 x 7.20 x 7.21 mm
