birgerjohansson/Epi/Models/EpiTorso/Eye/LEDDiffuser.3mf

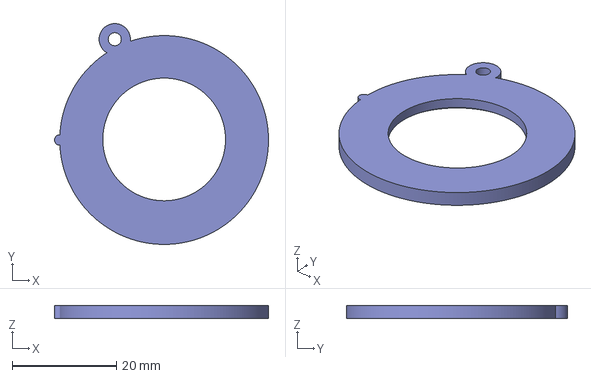
[picture p55: CAD file, 2022-10-13]
Models/EpiTorso/Eye/LEDDiffuser.3mf
41.0 x 42.3 x 2.50 mm
