birgerjohansson/Epi/Models/EpiTorso/PowerBoardMountFront.3mf

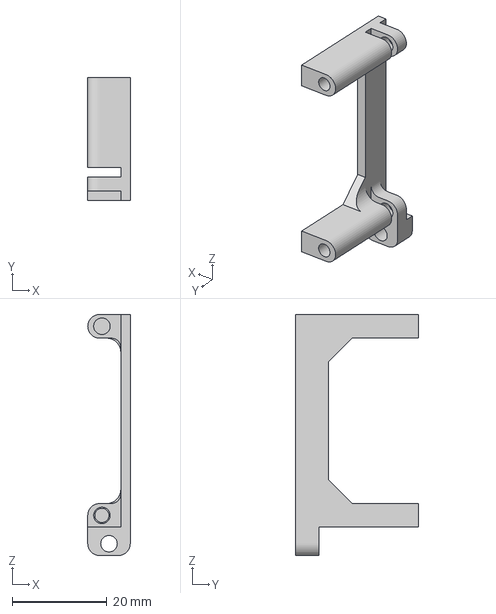
[picture p56: CAD file, 2022-10-12]
Models/EpiTorso/PowerBoardMountFront.3mf
9.00 x 26.0 x 51.0 mm
