birgerjohansson/Epi/Models/Epi/Arm/Left/Bottom.step

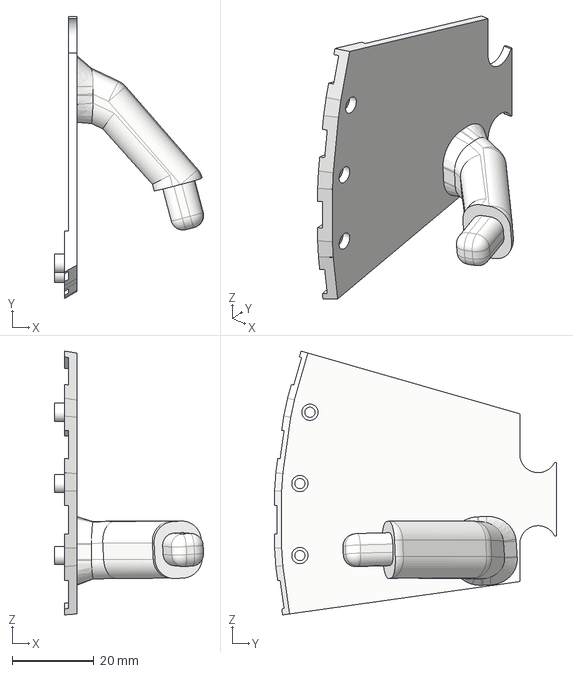
[picture p57: CAD file, 2019-03-13]
Models/Epi/Arm/Left/Bottom.step
36.6 x 69.2 x 64.7 mm
