birgerjohansson/Epi/Models/Epi/Arm/UpperArm.step

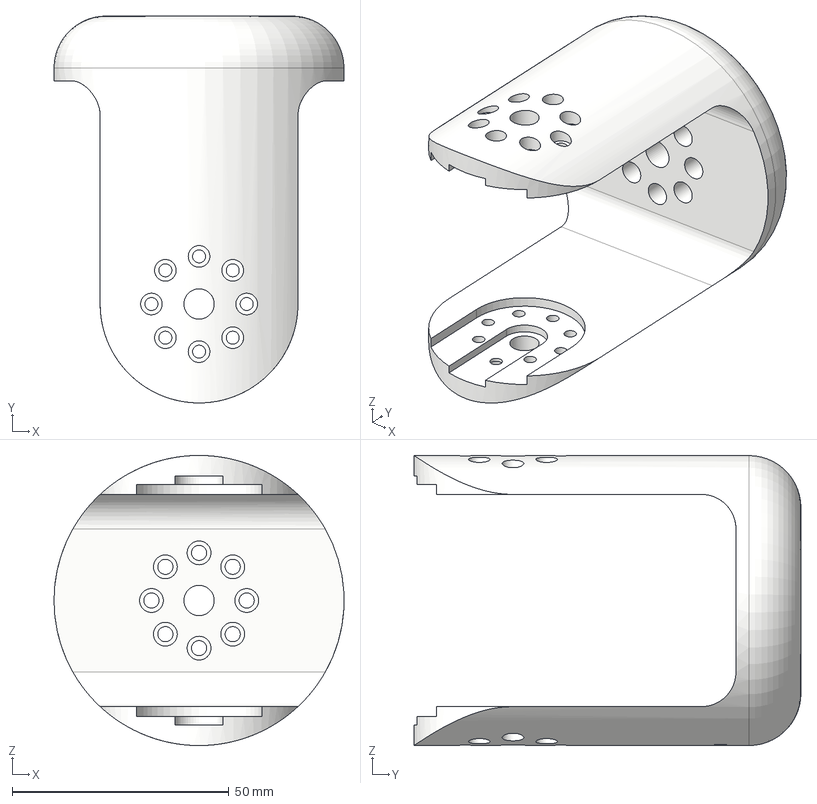
[picture p58: CAD file, 2019-03-13]
Models/Epi/Arm/UpperArm.step
67.0 x 89.3 x 67.0 mm
