birgerjohansson/Epi/Models/Epi/Head/Eye/IrisGear.step

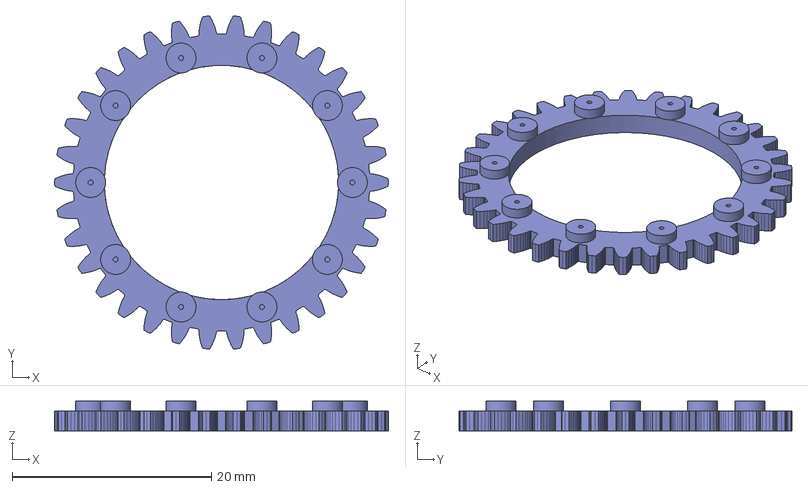
[picture p59: CAD file, 2019-03-13]
Models/Epi/Head/Eye/IrisGear.step
33.5 x 33.4 x 3.00 mm
