birgerjohansson/Epi/Models/Epi/Head/Mouth.step

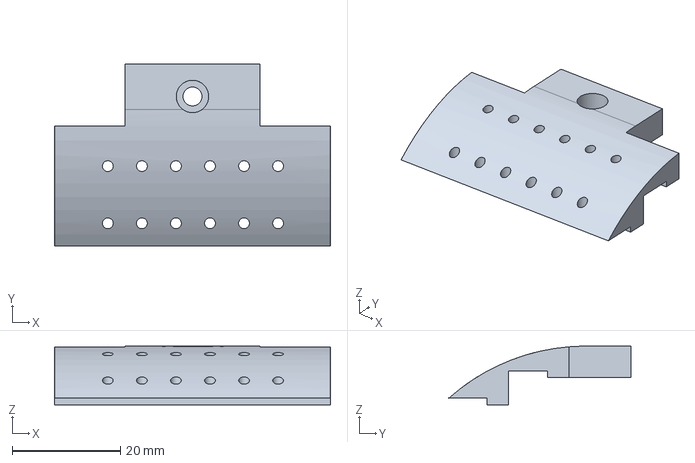
[picture p60: CAD file, 2019-03-13]
Models/Epi/Head/Mouth.step
51.1 x 33.7 x 10.9 mm
