birgerjohansson/Epi/Models/EpiKeyring/Epi_twoColorKeyringHead.3mf

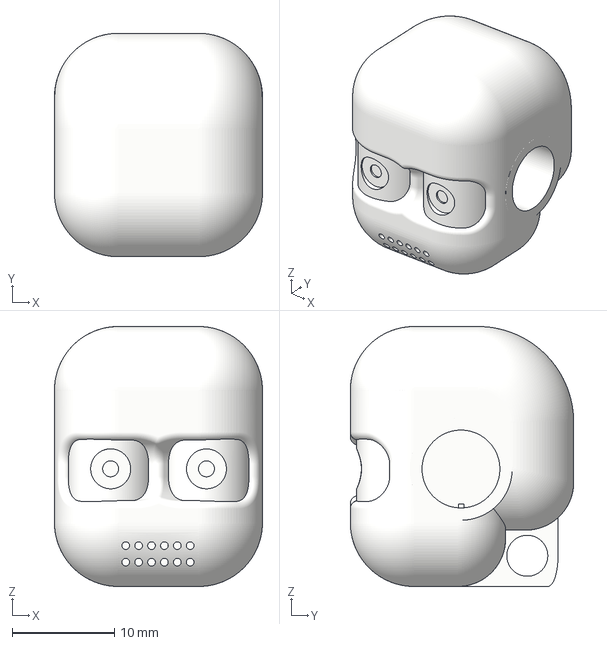
[picture p61: CAD file, 2022-11-29]
Models/EpiKeyring/Epi_twoColorKeyringHead.3mf
20.3 x 21.8 x 25.4 mm
