birgerjohansson/Epi/Models/EpiTorso/Eye/InnerBody.3mf

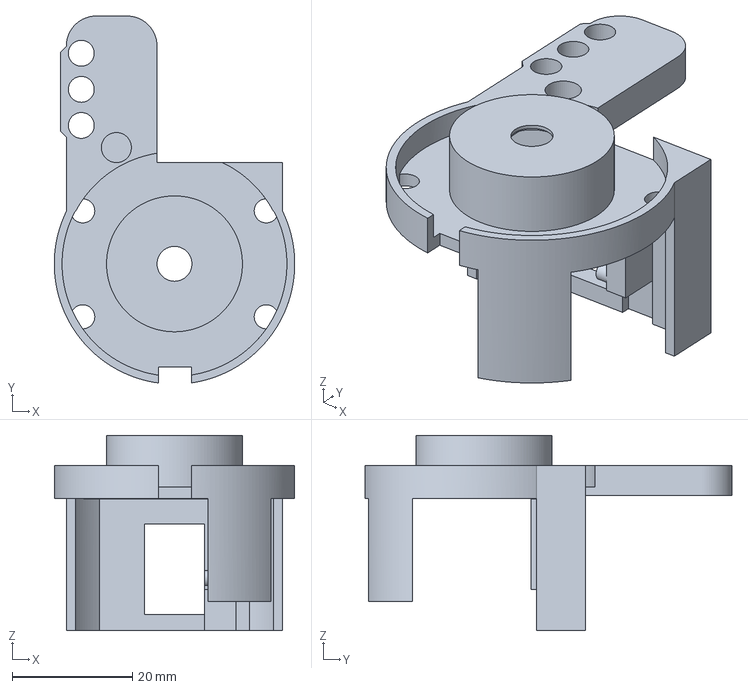
[picture p62: CAD file, 2022-10-13]
Models/EpiTorso/Eye/InnerBody.3mf
40.0 x 61.0 x 32.5 mm
