birgerjohansson/Epi/Models/EpiTorso/Mouth.3mf

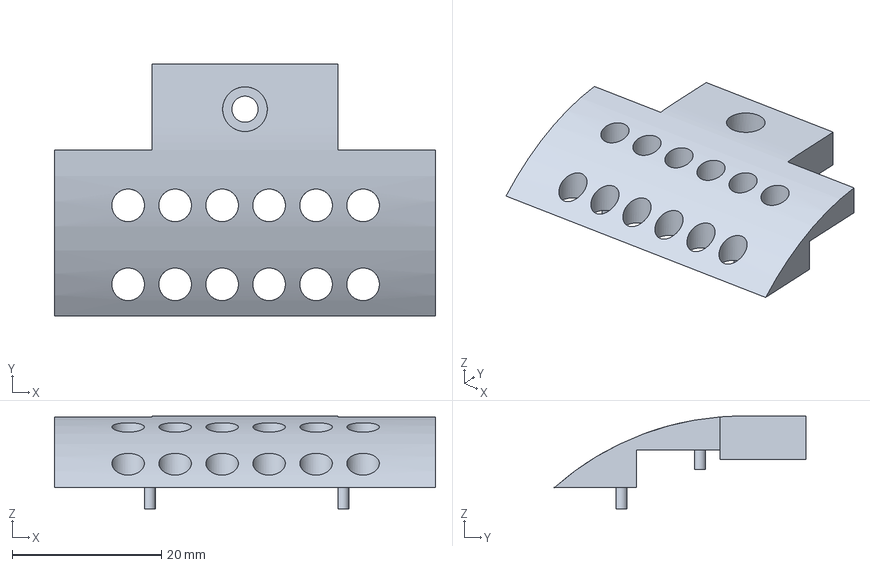
[picture p63: CAD file, 2022-10-12]
Models/EpiTorso/Mouth.3mf
51.1 x 33.7 x 12.5 mm
