birgerjohansson/Epi/Models/Epi/Arm/Moving.step

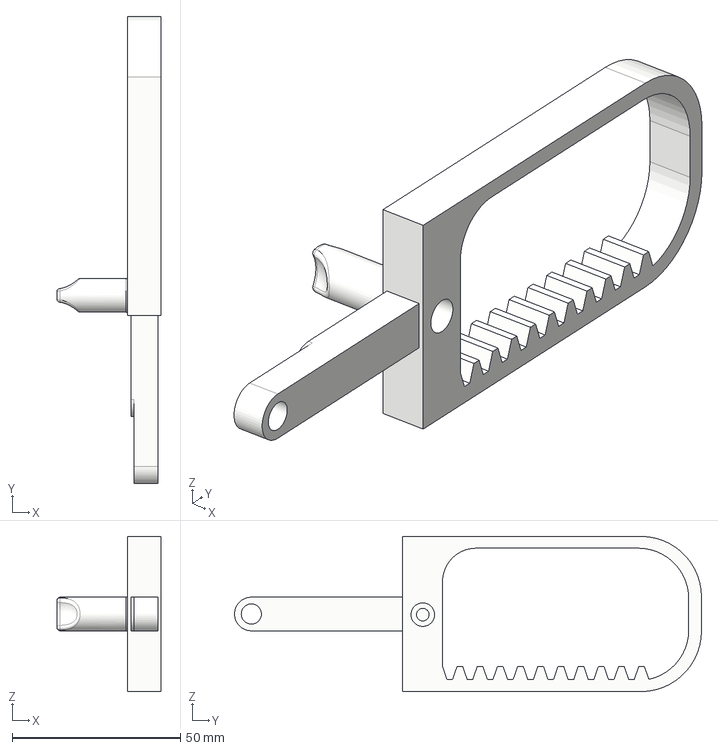
[picture p64: CAD file, 2019-03-13]
Models/Epi/Arm/Moving.step
31.0 x 138.8 x 46.1 mm
