birgerjohansson/Epi/Models/Epi/Head/Eye/IrisBlade.step

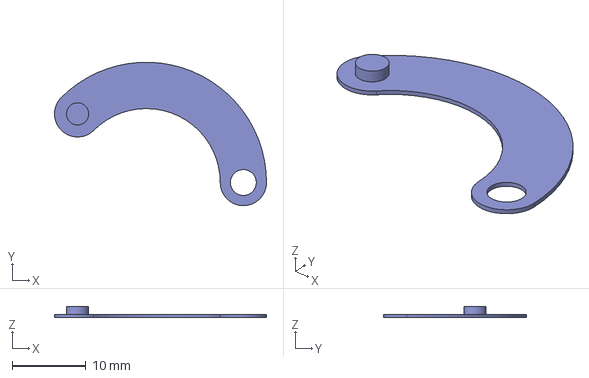
[picture p65: CAD file, 2019-03-13]
Models/Epi/Head/Eye/IrisBlade.step
28.7 x 19.4 x 1.50 mm
