birgerjohansson/Epi/Models/Epi/Head/EyeBackWall.step

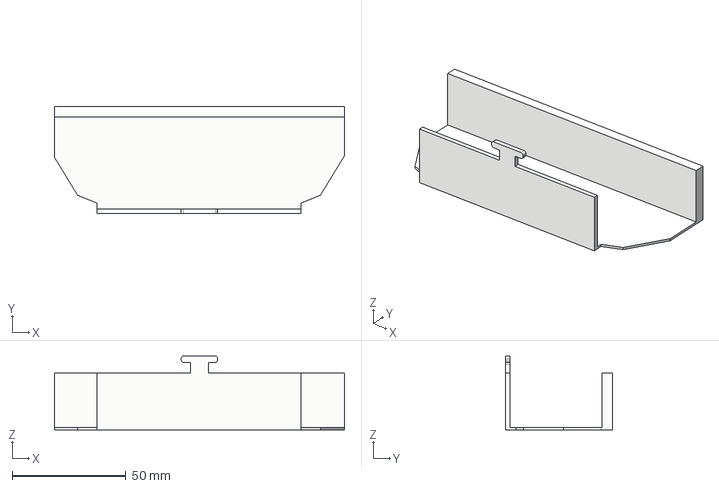
[picture p66: CAD file, 2019-03-13]
Models/Epi/Head/EyeBackWall.step
127.5 x 46.9 x 32.5 mm
