birgerjohansson/Epi/Models/EpiKeyring/Epi_twoColorKeyringEarOuter.3mf

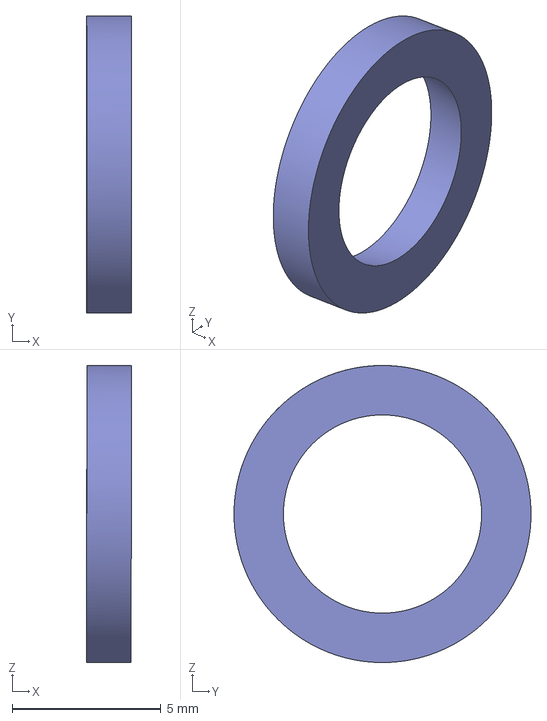
[picture p67: CAD file, 2022-11-29]
Models/EpiKeyring/Epi_twoColorKeyringEarOuter.3mf
1.51 x 10.00 x 10.0 mm
