birgerjohansson/Epi/Models/EpiTorso/BottomCover.3mf

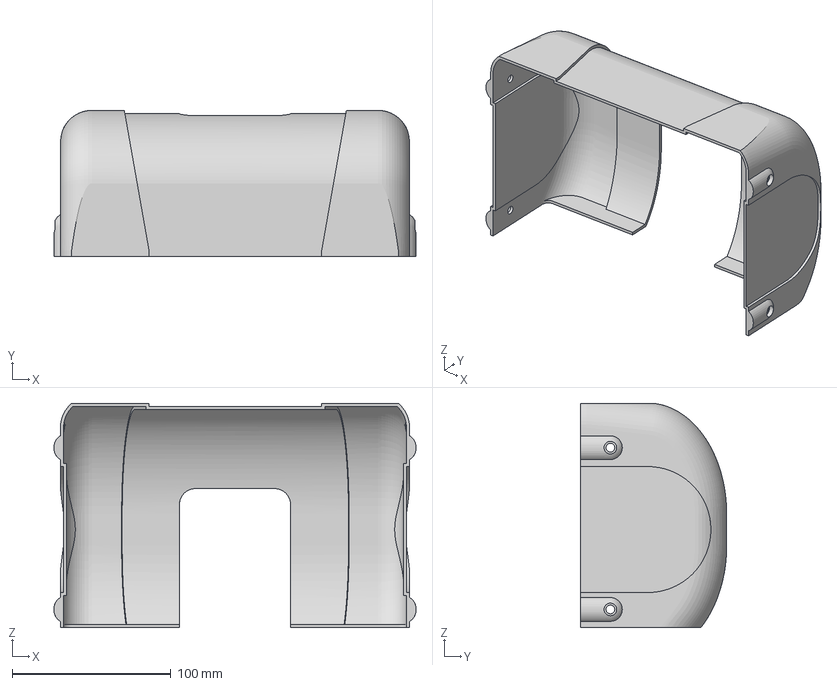
[picture p68: CAD file, 2022-10-12]
Models/EpiTorso/BottomCover.3mf
228.3 x 92.3 x 141.4 mm
