birgerjohansson/Epi/Models/Epi/Arm/LowerArm4.step

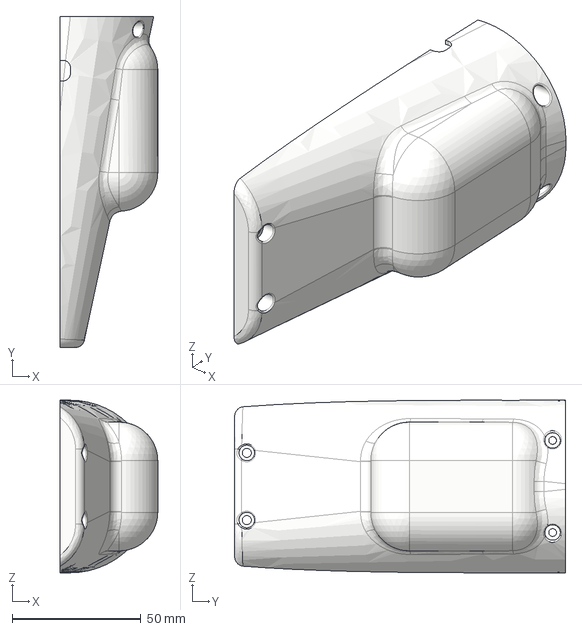
[picture p69: CAD file, 2019-03-13]
Models/Epi/Arm/LowerArm4.step
37.9 x 128.5 x 67.0 mm
