birgerjohansson/Epi/Models/Epi/Head/Ear.step

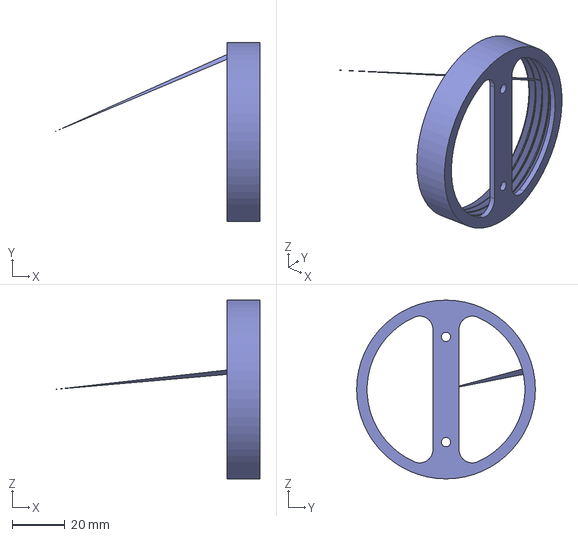
[picture p70: CAD file, 2019-03-13]
Models/Epi/Head/Ear.step
78.4 x 68.0 x 68.0 mm
