birgerjohansson/Epi/Models/EpiKeyring/Epi_singleColorKeyring.3mf

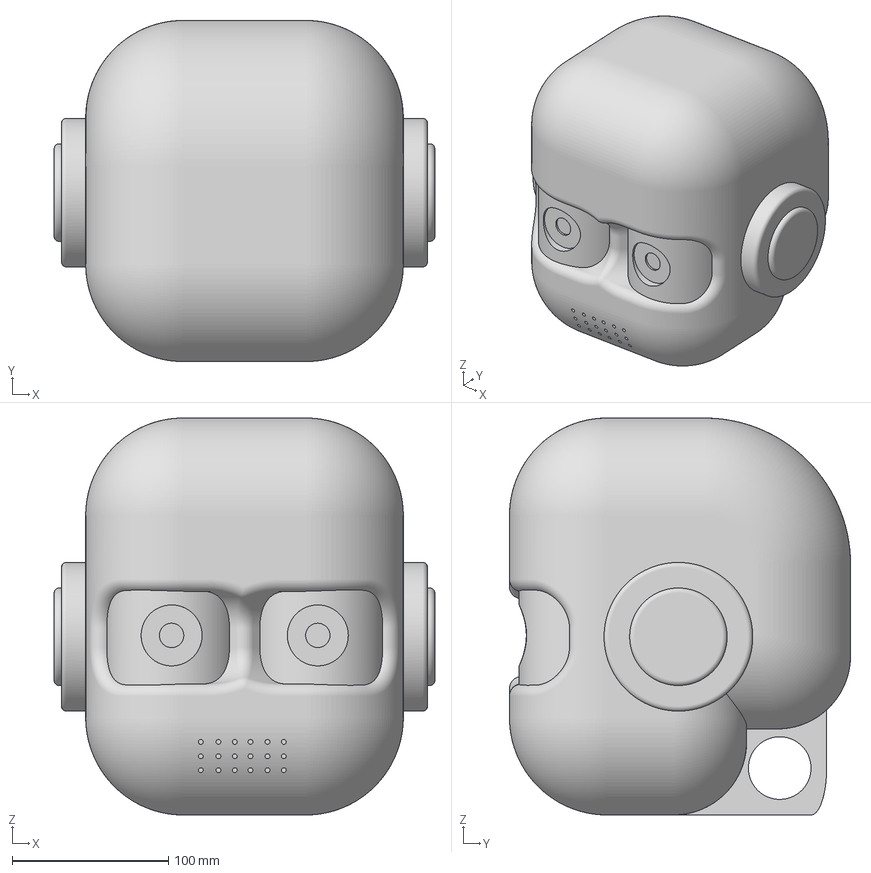
[picture p71: CAD file, 2022-11-29]
Models/EpiKeyring/Epi_singleColorKeyring.3mf
243.4 x 218.1 x 253.9 mm
