birgerjohansson/Epi/Models/EpiTorso/Eye/IrisFront.3mf

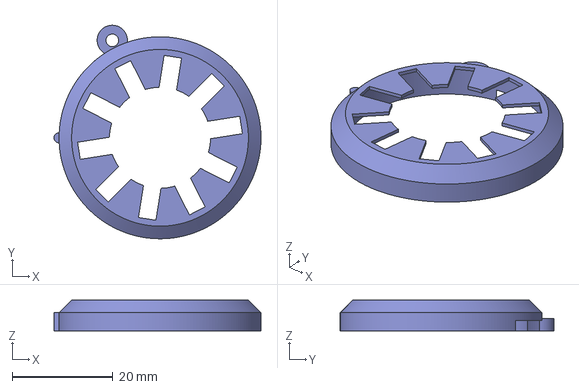
[picture p72: CAD file, 2022-10-13]
Models/EpiTorso/Eye/IrisFront.3mf
41.0 x 42.3 x 6.10 mm
