birgerjohansson/Epi/Models/EpiTorso/HeadFrameHorizontal.3mf

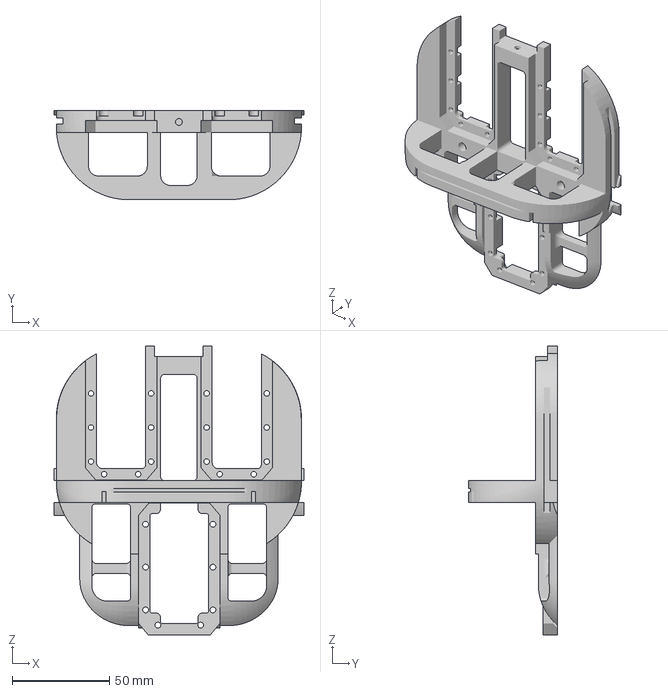
[picture p73: CAD file, 2022-10-12]
Models/EpiTorso/HeadFrameHorizontal.3mf
128.3 x 46.0 x 148.5 mm
