birgerjohansson/Epi/Models/Epi/Arm/tendon_20_3mm.step

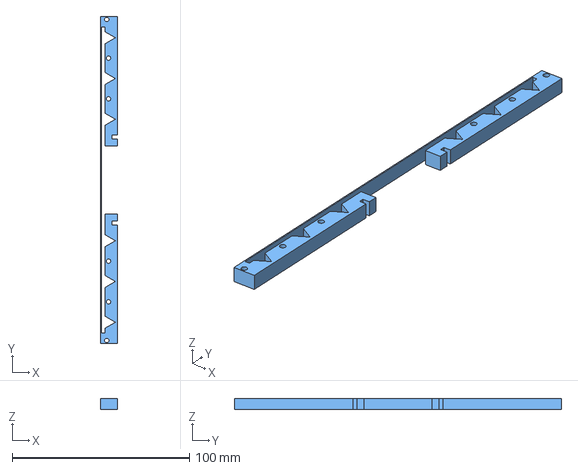
[picture p74: CAD file, 2019-03-13]
Models/Epi/Arm/tendon_20_3mm.step
9.50 x 184.6 x 6.00 mm
