birgerjohansson/Epi/Models/Epi/Head/Eye/BackPlate.step

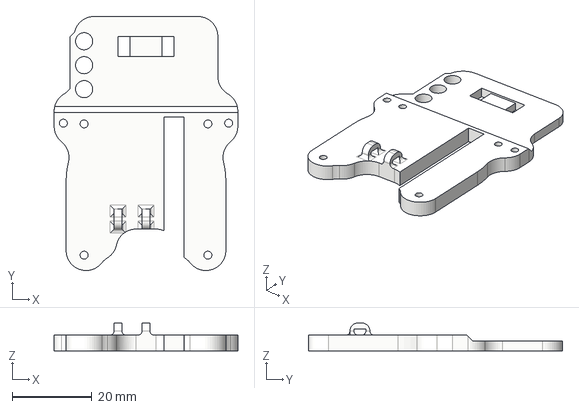
[picture p75: CAD file, 2019-03-13]
Models/Epi/Head/Eye/BackPlate.step
46.0 x 63.6 x 7.00 mm
