birgerjohansson/Epi/Models/Epi/Head/HorizontalMount.step

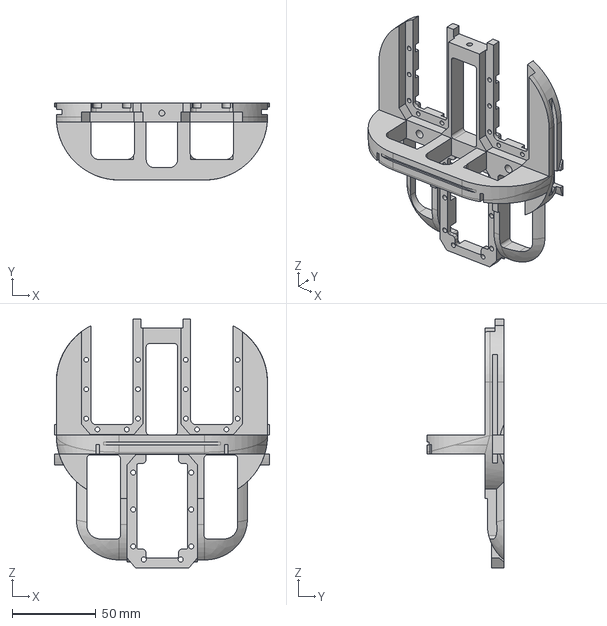
[picture p76: CAD file, 2019-03-13]
Models/Epi/Head/HorizontalMount.step
128.3 x 46.0 x 148.5 mm
