birgerjohansson/Epi/Models/EpiTorso/SpeakerMount.3mf

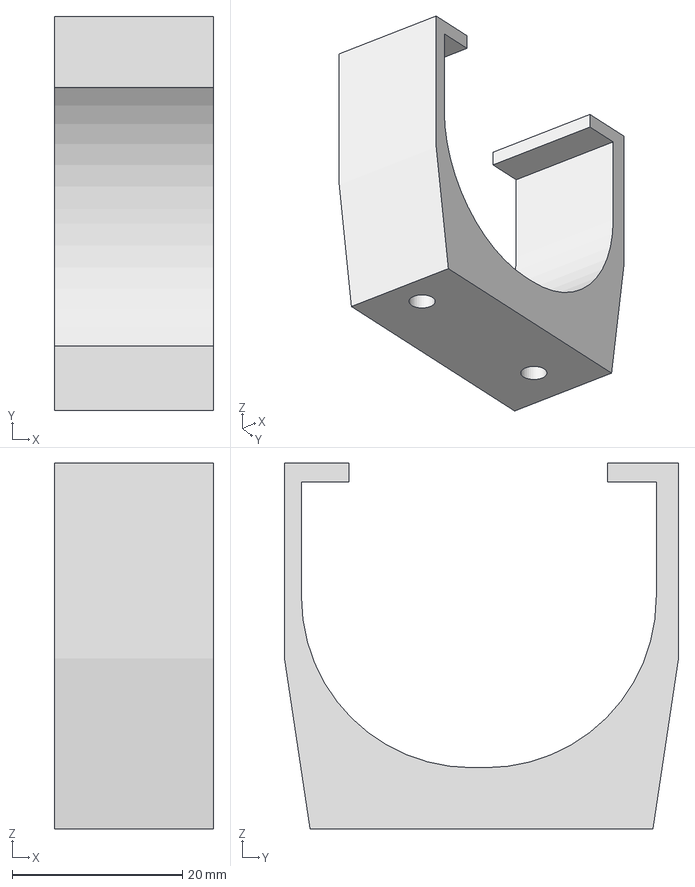
[picture p77: CAD file, 2022-10-12]
Models/EpiTorso/SpeakerMount.3mf
18.7 x 46.3 x 43.0 mm
