birgerjohansson/Epi/Models/Epi/Arm/EpiFinger.step

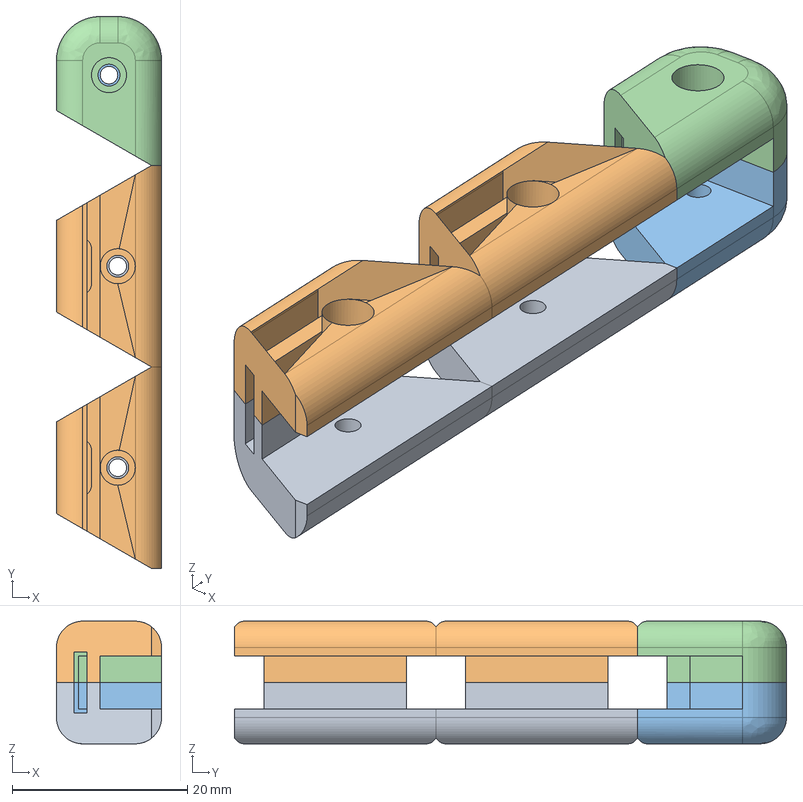
[picture p78: CAD file, 2019-03-13]
Models/Epi/Arm/EpiFinger.step
12.0 x 63.0 x 14.0 mm
