birgerjohansson/Epi/Models/Epi/Head/Back.step

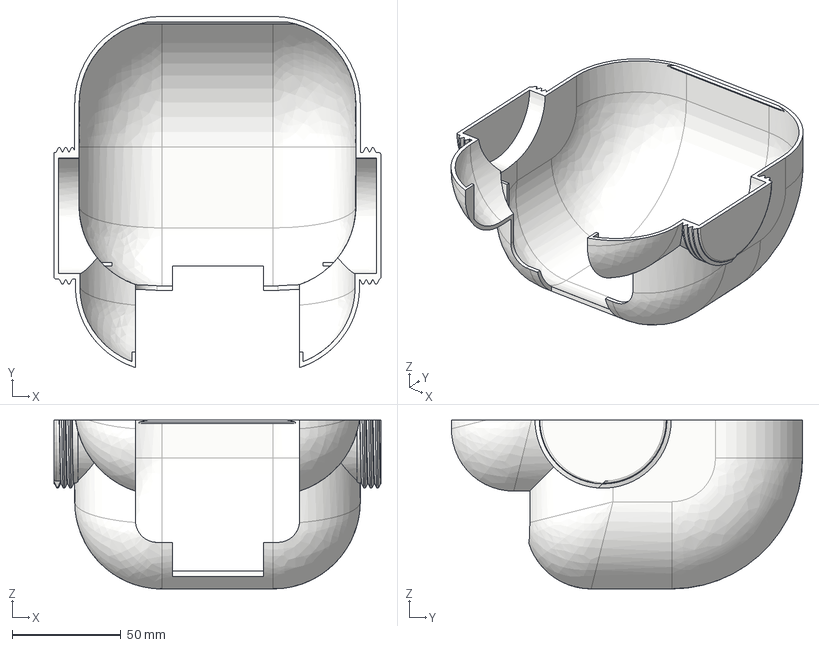
[picture p79: CAD file, 2019-03-13]
Models/Epi/Head/Back.step
150.0 x 161.1 x 77.5 mm
