birgerjohansson/Epi/Models/EpiTorso/Bottom.3mf

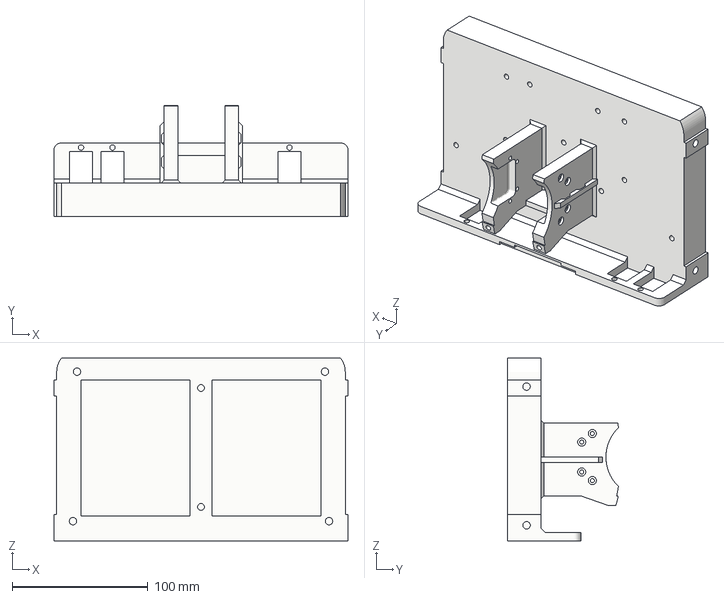
[picture p80: CAD file, 2022-10-12]
Models/EpiTorso/Bottom.3mf
216.3 x 81.6 x 134.4 mm
