birgerjohansson/Epi/Models/Epi/Arm/Gear.step

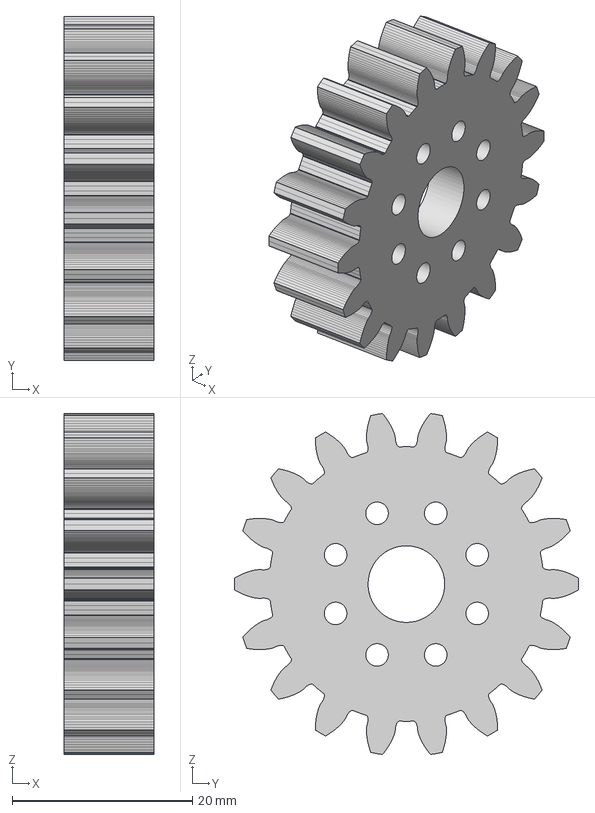
[picture p81: CAD file, 2019-03-13]
Models/Epi/Arm/Gear.step
10.00 x 38.2 x 37.8 mm
