birgerjohansson/Epi/Models/Epi/Head/EarCap.step

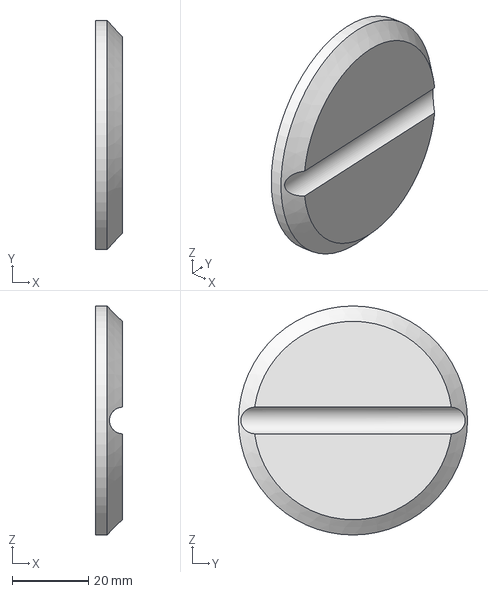
[picture p82: CAD file, 2019-03-13]
Models/Epi/Head/EarCap.step
7.00 x 60.0 x 60.0 mm
