birgerjohansson/Epi/Models/Epi/Head/Eye/ServoGear.step

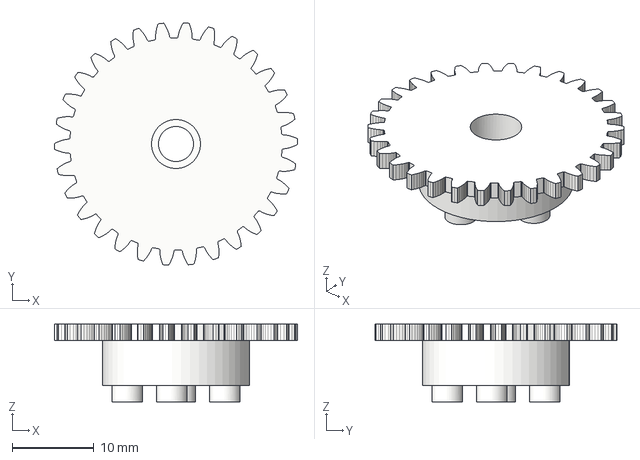
[picture p83: CAD file, 2019-03-13]
Models/Epi/Head/Eye/ServoGear.step
29.8 x 29.7 x 9.50 mm
