birgerjohansson/Epi/Models/EpiTorso/USBMountBackLeft.3mf

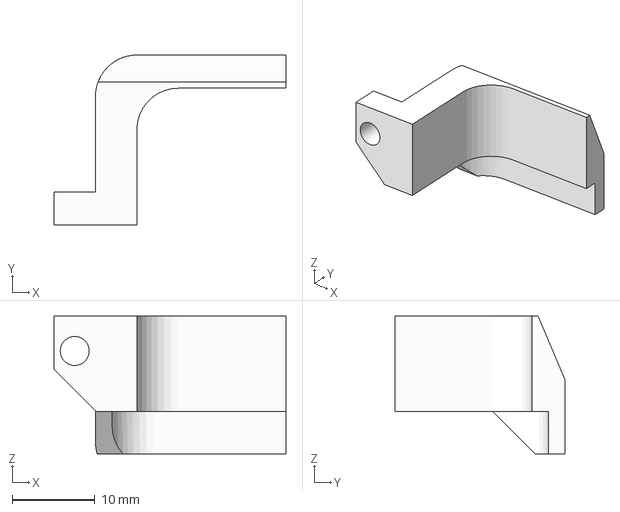
[picture p84: CAD file, 2022-10-12]
Models/EpiTorso/USBMountBackLeft.3mf
28.0 x 20.5 x 16.6 mm
