birgerjohansson/Epi/Models/Epi/Arm/LowerArm3.step

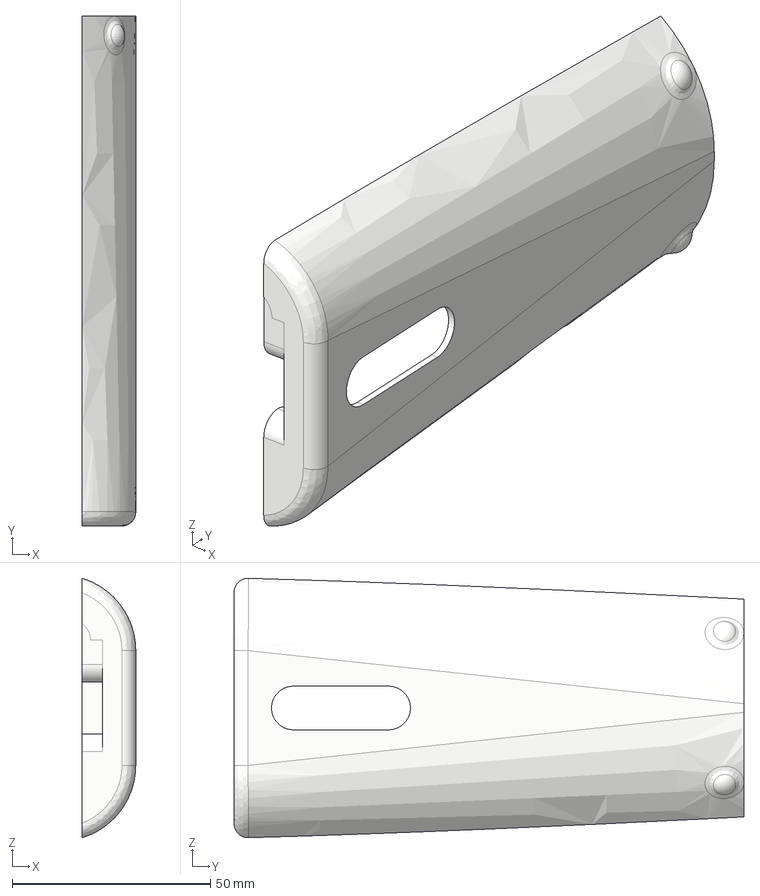
[picture p85: CAD file, 2019-03-13]
Models/Epi/Arm/LowerArm3.step
13.5 x 128.5 x 65.4 mm
