birgerjohansson/Epi/Models/Epi/Head/Front.step

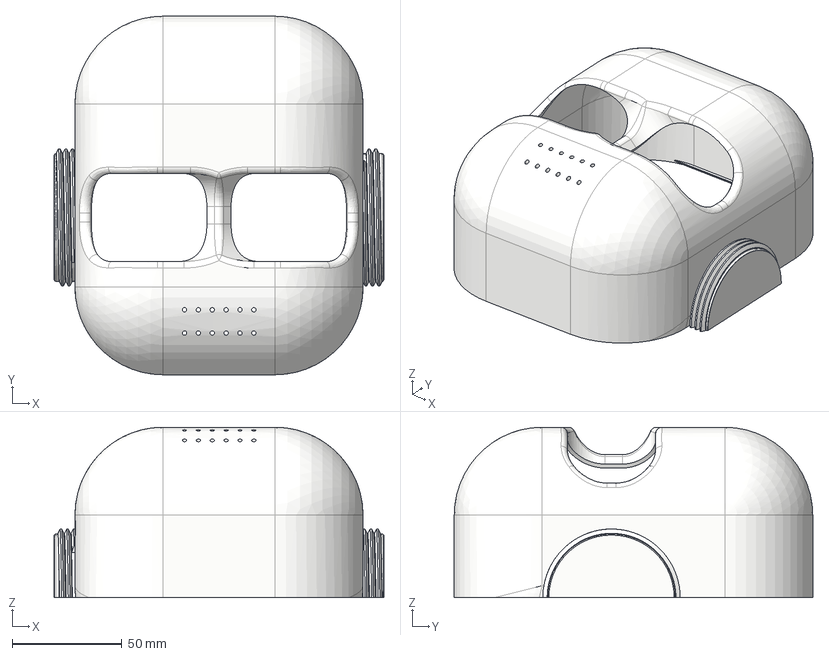
[picture p86: CAD file, 2019-03-13]
Models/Epi/Head/Front.step
150.0 x 163.0 x 77.5 mm
