birgerjohansson/Epi/Models/EpiTorso/Eye/ServoGear.3mf

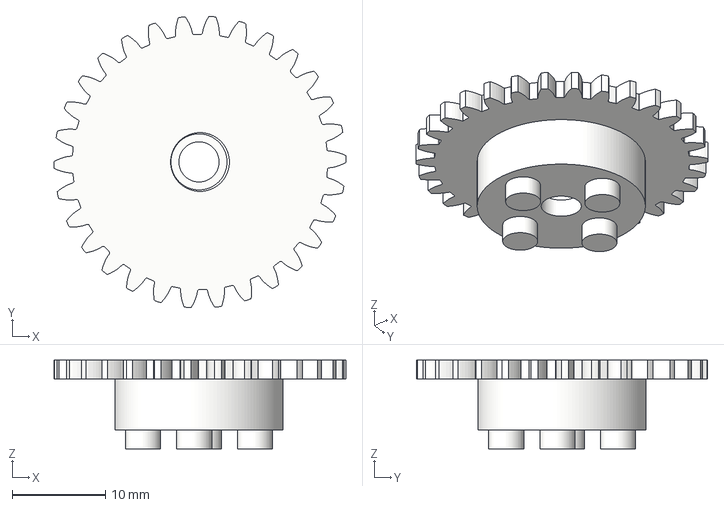
[picture p87: CAD file, 2022-10-13]
Models/EpiTorso/Eye/ServoGear.3mf
31.3 x 31.2 x 9.50 mm
