birgerjohansson/Epi/Models/EpiTorso/USBMountBackRight.3mf

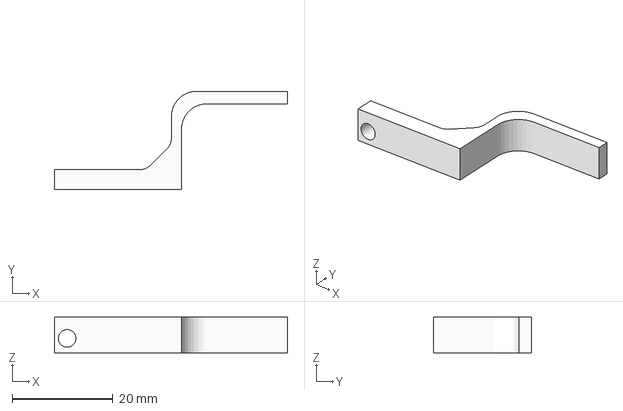
[picture p88: CAD file, 2022-10-12]
Models/EpiTorso/USBMountBackRight.3mf
46.1 x 19.5 x 7.05 mm
