birgerjohansson/Epi/Models/Epi/Arm/LowerArm1.step

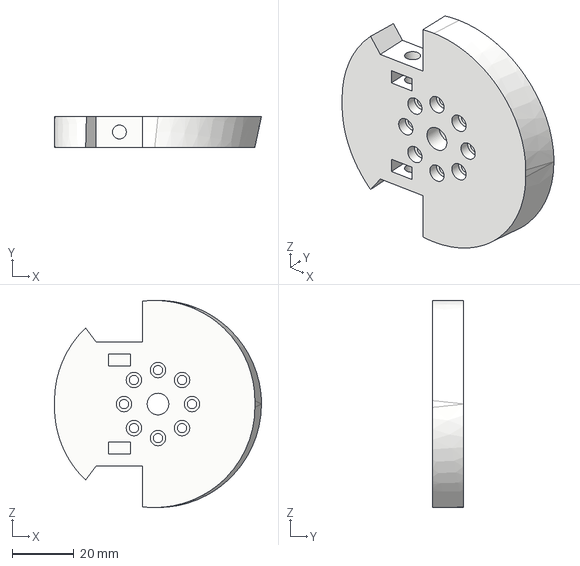
[picture p89: CAD file, 2019-03-13]
Models/Epi/Arm/LowerArm1.step
67.0 x 10.0 x 67.0 mm
