birgerjohansson/Epi/Models/EpiTorso/DynamixelMountBack.3mf

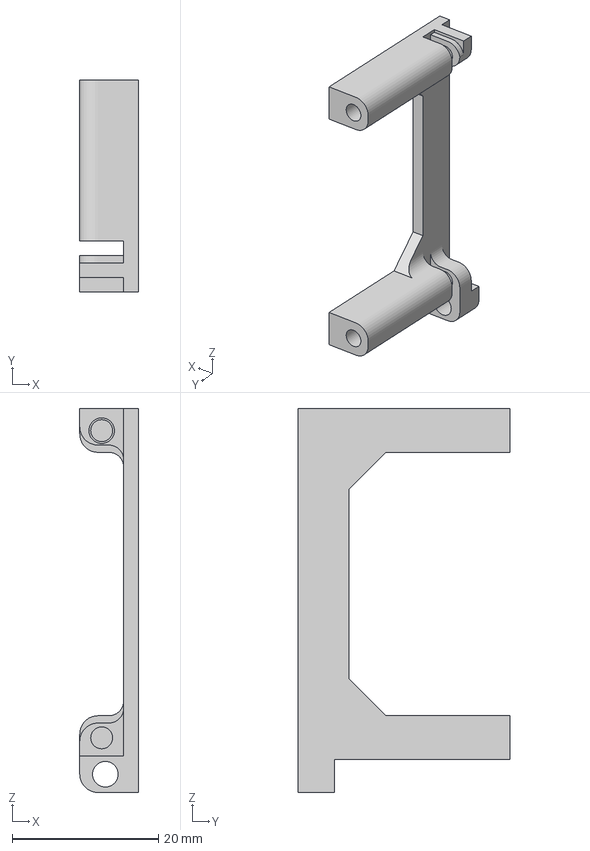
[picture p90: CAD file, 2022-10-12]
Models/EpiTorso/DynamixelMountBack.3mf
8.00 x 29.0 x 52.5 mm
