birgerjohansson/Epi/Models/Epi/Arm/ThumbTip.step

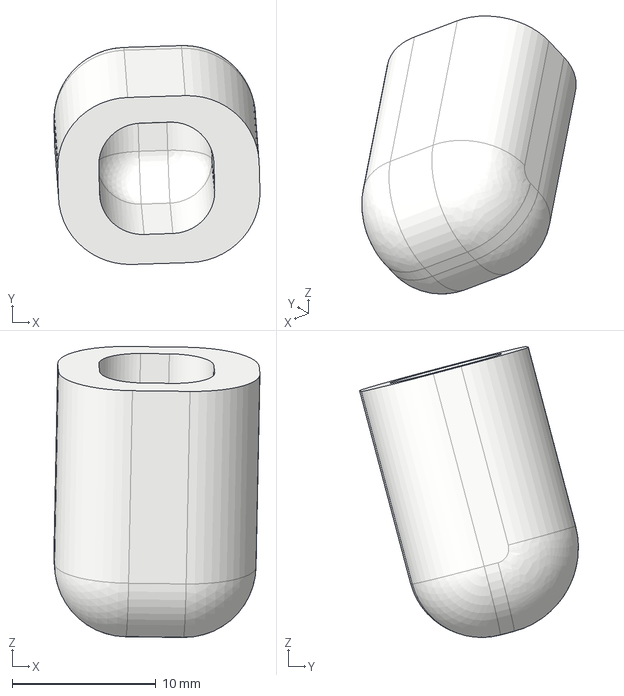
[picture p91: CAD file, 2019-03-13]
Models/Epi/Arm/ThumbTip.step
14.3 x 15.2 x 20.2 mm
