birgerjohansson/Epi/Models/EpiTorso/HeadBack.3mf

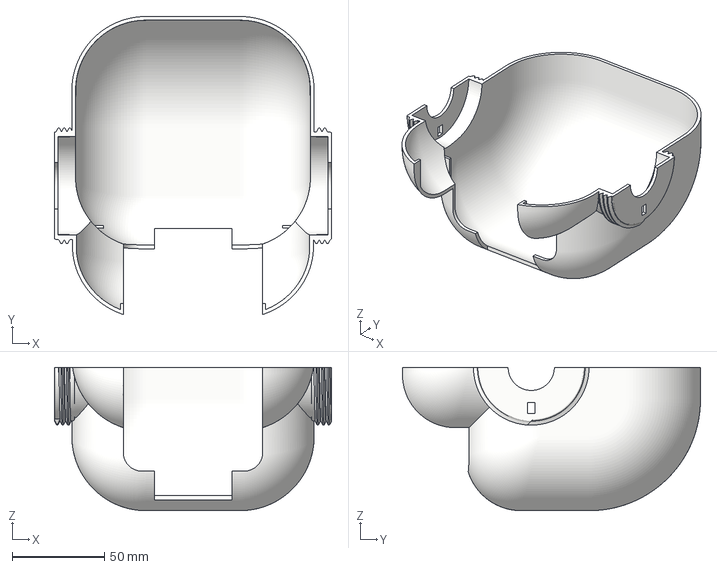
[picture p92: CAD file, 2022-10-12]
Models/EpiTorso/HeadBack.3mf
150.0 x 161.1 x 77.5 mm
