birgerjohansson/Epi/Models/EpiTorso/CablePlateBack.3mf

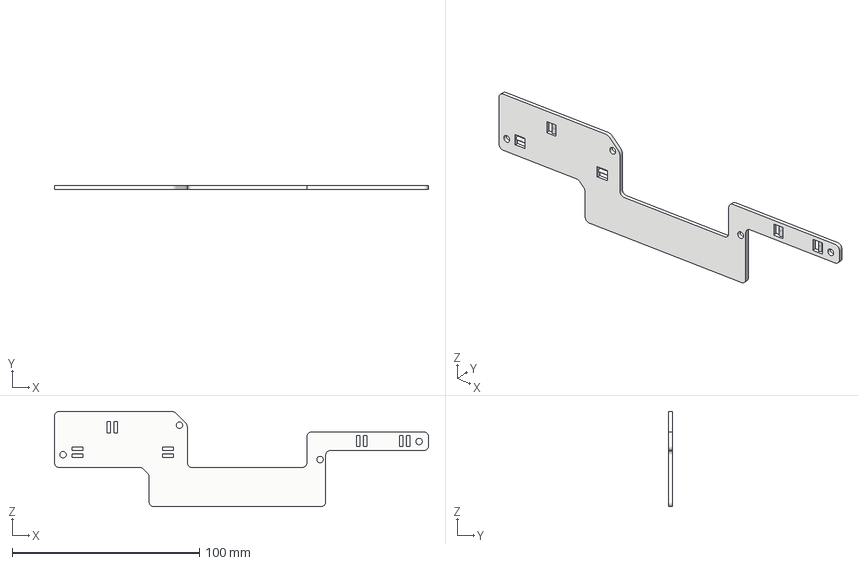
[picture p93: CAD file, 2022-10-12]
Models/EpiTorso/CablePlateBack.3mf
200.0 x 2.00 x 51.0 mm
