birgerjohansson/Epi/Models/EpiTorso/USBMountFrontLeft.3mf

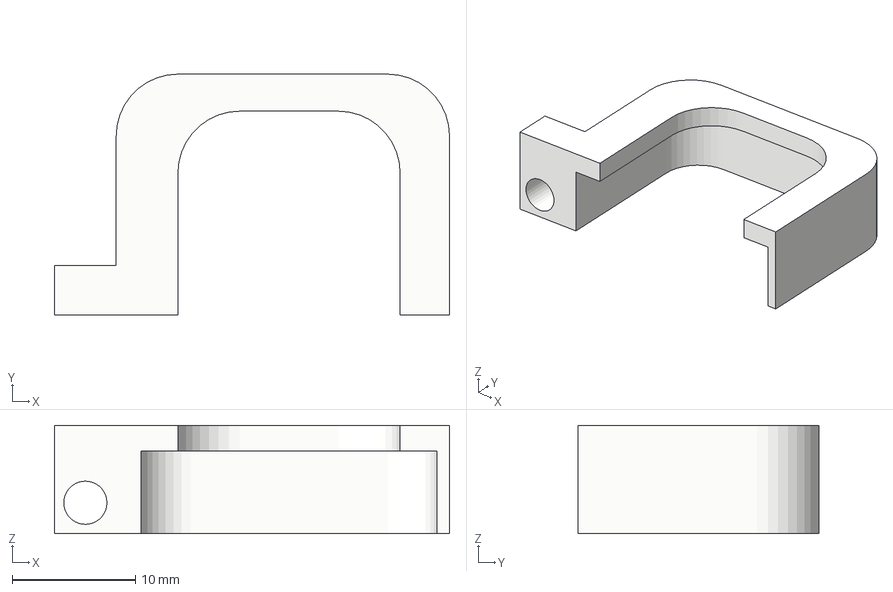
[picture p94: CAD file, 2022-10-12]
Models/EpiTorso/USBMountFrontLeft.3mf
32.0 x 19.5 x 8.77 mm
