birgerjohansson/Epi/Models/EpiTorso/USBMountFrontRight.3mf

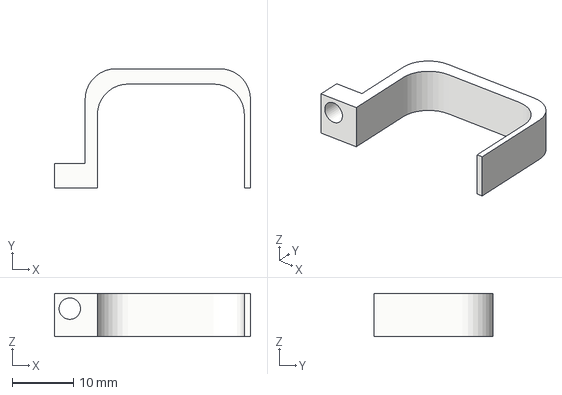
[picture p95: CAD file, 2022-10-12]
Models/EpiTorso/USBMountFrontRight.3mf
32.0 x 19.5 x 7.08 mm
