birgerjohansson/Epi/Models/EpiTorso/CablePlateFront.3mf

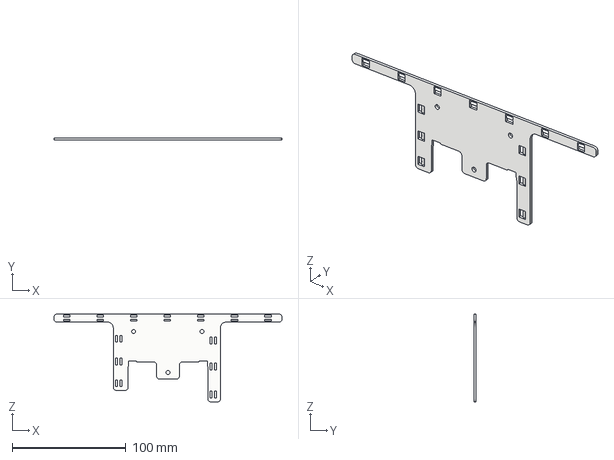
[picture p96: CAD file, 2022-10-12]
Models/EpiTorso/CablePlateFront.3mf
200.0 x 2.00 x 77.0 mm
