birgerjohansson/Epi/Models/EpiTorso/HeadFrameVertical.3mf

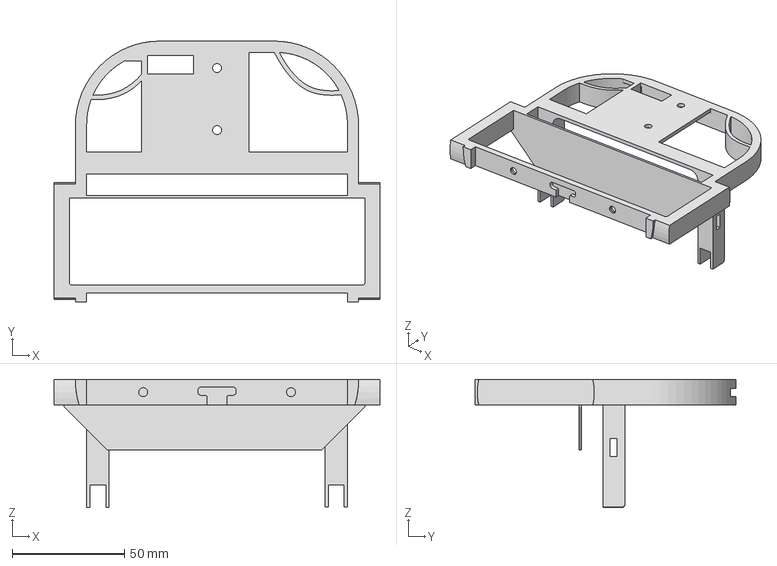
[picture p97: CAD file, 2022-10-12]
Models/EpiTorso/HeadFrameVertical.3mf
145.0 x 116.0 x 57.0 mm
