birgerjohansson/Epi/Models/EpiTorso/EarRing.3mf

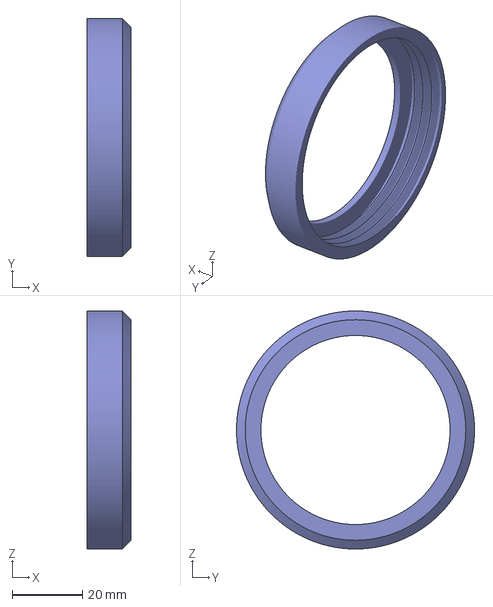
[picture p98: CAD file, 2022-10-12]
Models/EpiTorso/EarRing.3mf
12.6 x 68.0 x 68.0 mm
