birgerjohansson/Epi/Models/EpiTorso/FadeCandyHolder.3mf

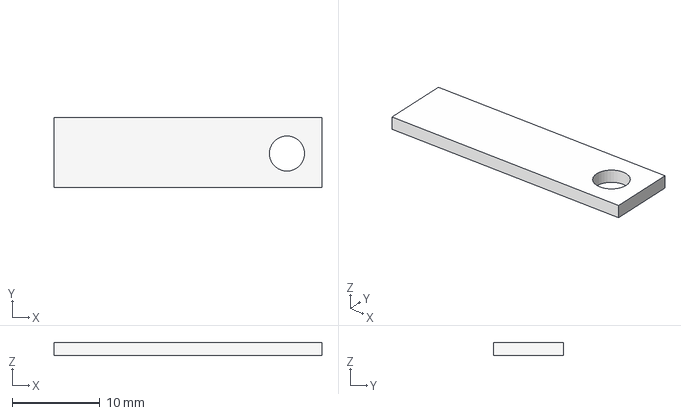
[picture p99: CAD file, 2022-10-12]
Models/EpiTorso/FadeCandyHolder.3mf
30.5 x 8.00 x 1.50 mm
