birgerjohansson/Epi/Models/EpiTorso/DynamixelMountFront.3mf

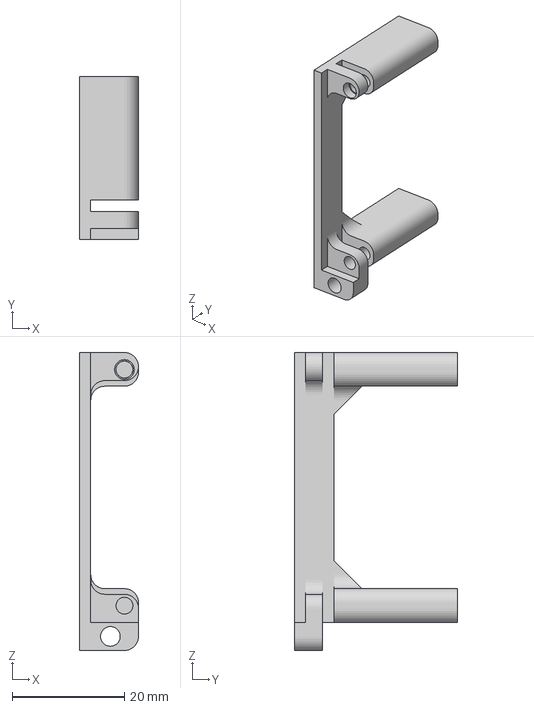
[picture p100: CAD file, 2022-10-12]
Models/EpiTorso/DynamixelMountFront.3mf
10.5 x 29.0 x 53.0 mm
