birgerjohansson/Epi/Models/EpiTorso/BottomCoverBack.3mf

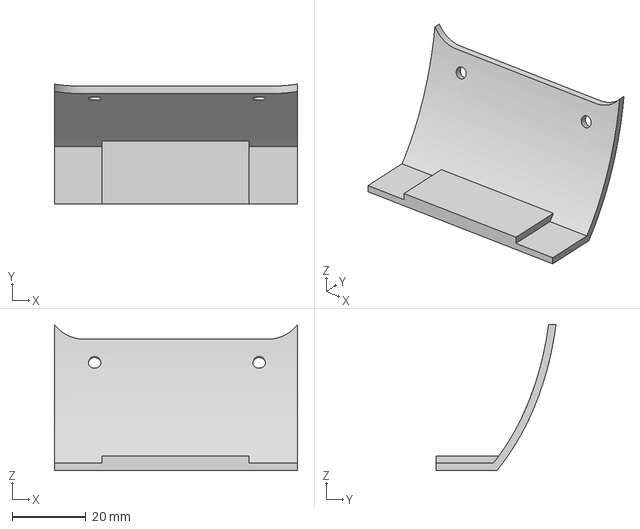
[picture p101: CAD file, 2022-10-12]
Models/EpiTorso/BottomCoverBack.3mf
66.0 x 32.6 x 39.7 mm
