birgerjohansson/Epi/Models/EpiTorso/WeightPlate.3mf

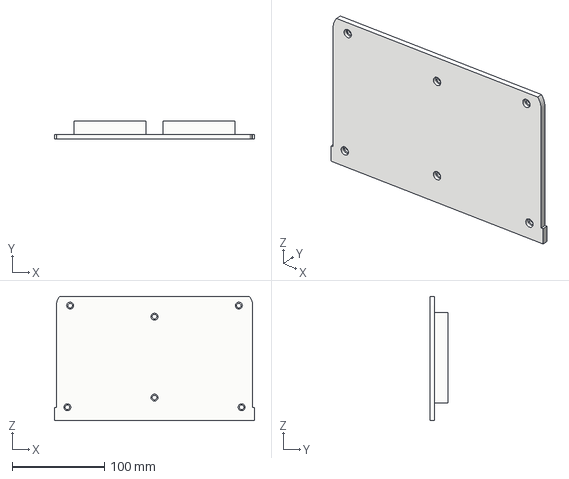
[picture p102: CAD file, 2022-10-12]
Models/EpiTorso/WeightPlate.3mf
216.3 x 20.0 x 134.4 mm
