birgerjohansson/Epi/Models/EpiTorso/EarCover.3mf

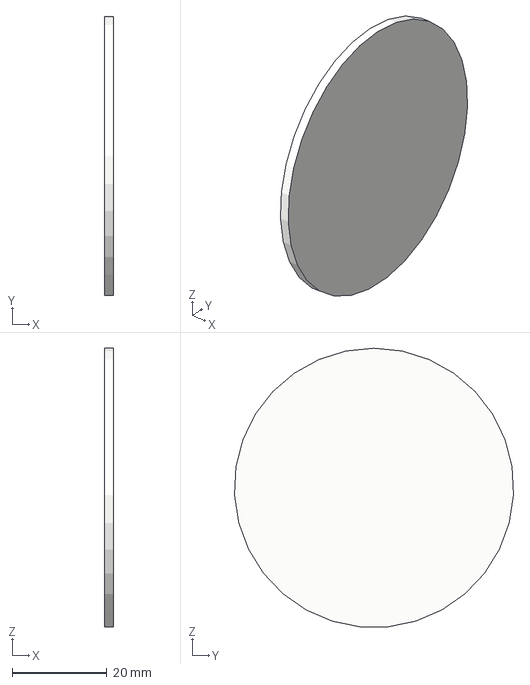
[picture p103: CAD file, 2022-10-12]
Models/EpiTorso/EarCover.3mf
2.00 x 58.9 x 58.8 mm
