birgerjohansson/Epi/Models/EpiTorso/HeadFront.3mf

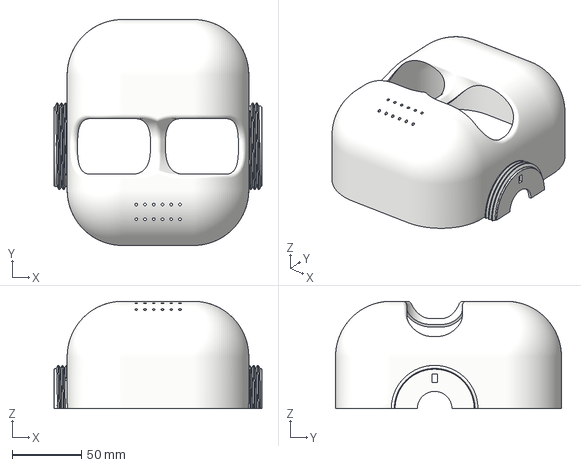
[picture p104: CAD file, 2022-10-12]
Models/EpiTorso/HeadFront.3mf
150.0 x 163.0 x 77.5 mm
