birgerjohansson/Epi/(list of files, cad)

Other CAD files:
Models/Epi/Arm/Right/Top.step
Models/Epi/Arm/Left/FingerMount.step
Models/Epi/Arm/Right/Bottom.step
Models/EpiTorso/Eye/OuterBody.3mf
Models/Epi/Head/Eye/InnerBody.step
Models/EpiTorso/Eye/IrisBlade.3mf
Models/Epi/Head/Eye/LEDDiffuser.step
Models/EpiTorso/Eye/BackPlate.3mf
Models/EpiTorso/Eye/IrisGear.3mf
Models/EpiTorso/PowerBoardMountBack.3mf
Models/Epi/Arm/EpiFinger.stl
Models/Epi/Arm/Gear.stl
Models/Epi/Arm/Left/Bottom.stl
Models/Epi/Arm/Left/FingerMount.stl
Models/Epi/Arm/Left/Top.stl
Models/Epi/Arm/LowerArm1.stl
Models/Epi/Arm/LowerArm2.stl
Models/Epi/Arm/LowerArm3.stl
Models/Epi/Arm/LowerArm4.stl
Models/Epi/Arm/Moving.stl
Models/Epi/Arm/Right/Bottom.stl
Models/Epi/Arm/Right/FingerMount.stl
Models/Epi/Arm/Right/Top.stl
Models/Epi/Arm/ThumbTip.stl
Models/Epi/Arm/UpperArm.stl
Models/Epi/Arm/tendon_20_3mm.stl
Models/Epi/Head/Back.stl
Models/Epi/Head/Ear.stl
Models/Epi/Head/EarCap.stl
Models/Epi/Head/Eye/BackPlate.stl
Models/Epi/Head/Eye/InnerBody.stl
Models/Epi/Head/Eye/IrisBlade.stl
Models/Epi/Head/Eye/IrisGear.stl
Models/Epi/Head/Eye/LEDDiffuser.stl
Models/Epi/Head/Eye/OuterBody.stl
Models/Epi/Head/Eye/ServoGear.stl
Models/Epi/Head/EyeBackWall.stl
Models/Epi/Head/Front.stl
Models/Epi/Head/HorizontalMount.stl
Models/Epi/Head/Mouth.stl
Models/Epi/Head/VertcalMount.stl
