birgerjohansson/Epi/(threads)

Thread 2 (2019-03-22):

Body rotation is not align with head rotation.

birgerjohansson, 2019-03-22:
Center line is 1.6 mm off

birgerjohansson, 2022-04-12:
Not sure if this is still the case. The head has been redesigned.

Closed 2022-04-12.

Thread 3 (2023-04-13):

EpiWhite

birgerjohansson, 2023-04-13:
Fadecandy does not work. 5 volt to board, USB comminution blinks but nothing on the LEDs. Probably the fadecandy board needs to be replaced.

Closed 2025-02-26.
