birgerjohansson/Epi/Drawings/EpiTorso Drawing.pdf

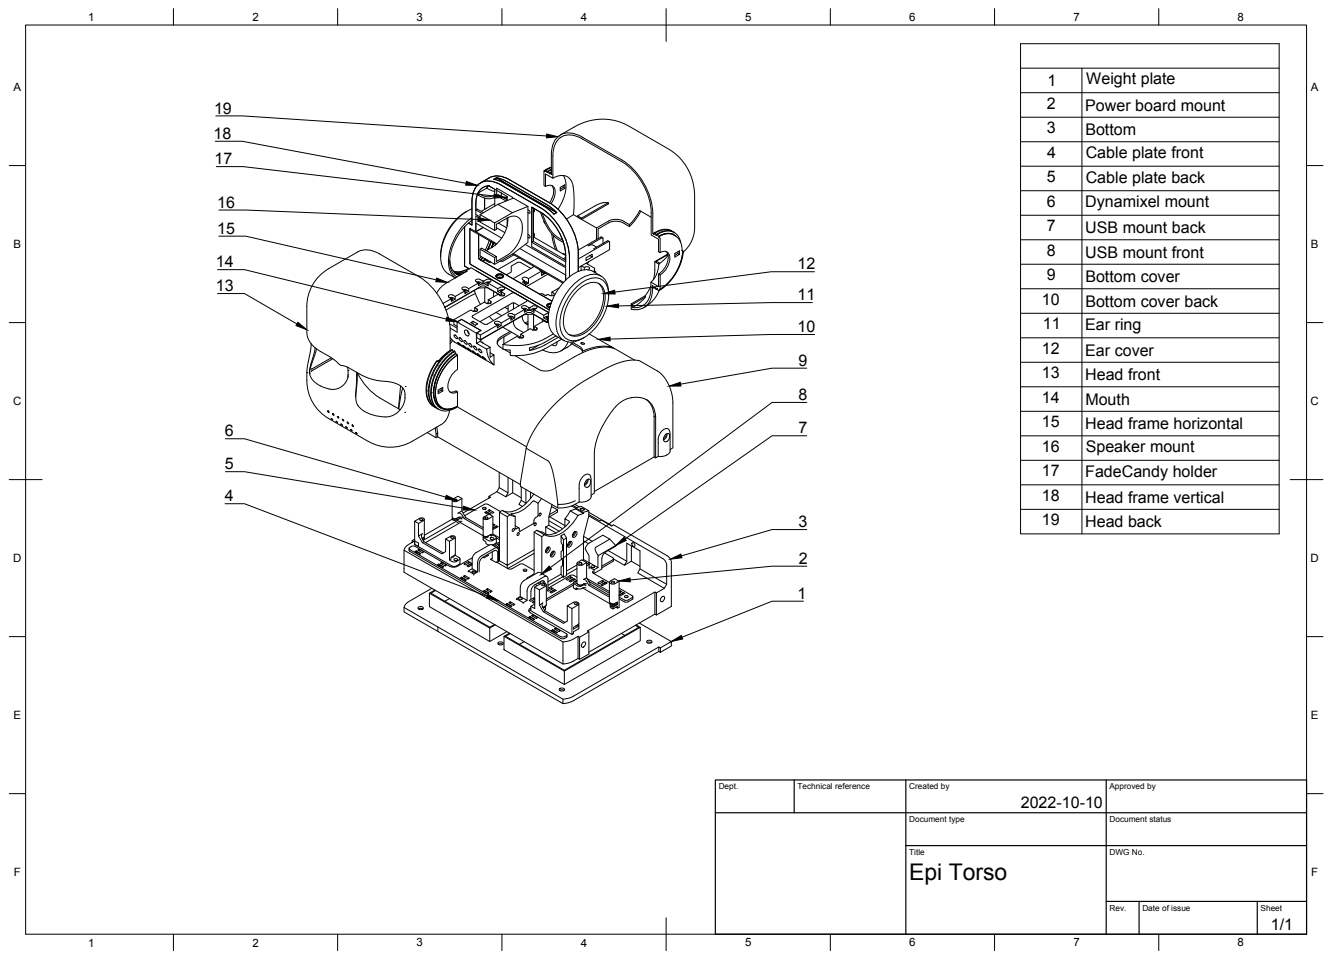
[picture p105: page 1]
8 BCDEF; ABCDEF; Title; DWG No.; Rev.; Date of issue; Sheet; Epi Torso; Weight plate 2; Power board mount 3; Bottom 4; Cable plate front 5; Cable plate back 6; Dynamixel mount 7; USB mount back 8; USB mount front 9; Bottom cover; Head back 13 546

10 | Bottom cover back
11 | Ear ring
12 | Ear cover
13 | Head front
14 | Mouth
15 | Head frame horizontal
16 | Speaker mount
17 | FadeCandy holder
18 | Head frame vertical

Dept. | Technical reference | Created by 2022-10-10 | Approved by

Document type | Document status
