birgerjohansson/Epi/Drawings/EpiEye Drawing.pdf

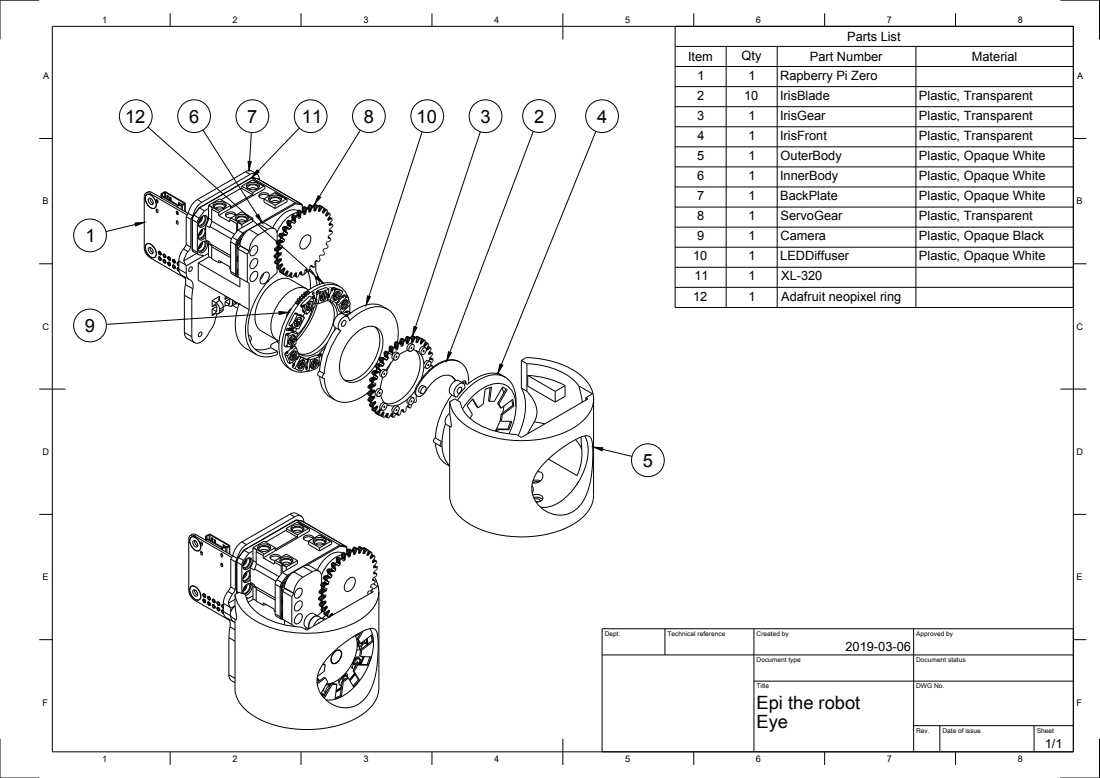
[picture p106: page 1]

Parts List

Item | Qty | Part Number | Material
1 | 1 | Rapberry Pi Zero
2 | 10 | IrisBlade | Plastic, Transparent
3 | 1 | IrisGear | Plastic, Transparent
4 | 1 | IrisFront | Plastic, Transparent
5 | 1 | OuterBody | Plastic, Opaque White
6 | 1 | InnerBody | Plastic, Opaque White
7 | 1 | BackPlate | Plastic, Opaque White
8 | 1 | ServoGear | Plastic, Transparent
9 | 1 | Camera | Plastic, Opaque Black
10 | 1 | LEDDiffuser | Plastic, Opaque White
11 | 1 | XL-320
12 | 1 | Adafruit neopixel ring

Dept. | Technical reference | Created by 2019-03-06 | Approved by

Document type | Document status

Title Epi the robot Eye | DWG No.

Rev. | Date of issue | Sheet 1/1
