birgerjohansson/Epi/Drawings/EpiRightArm Drawing.pdf

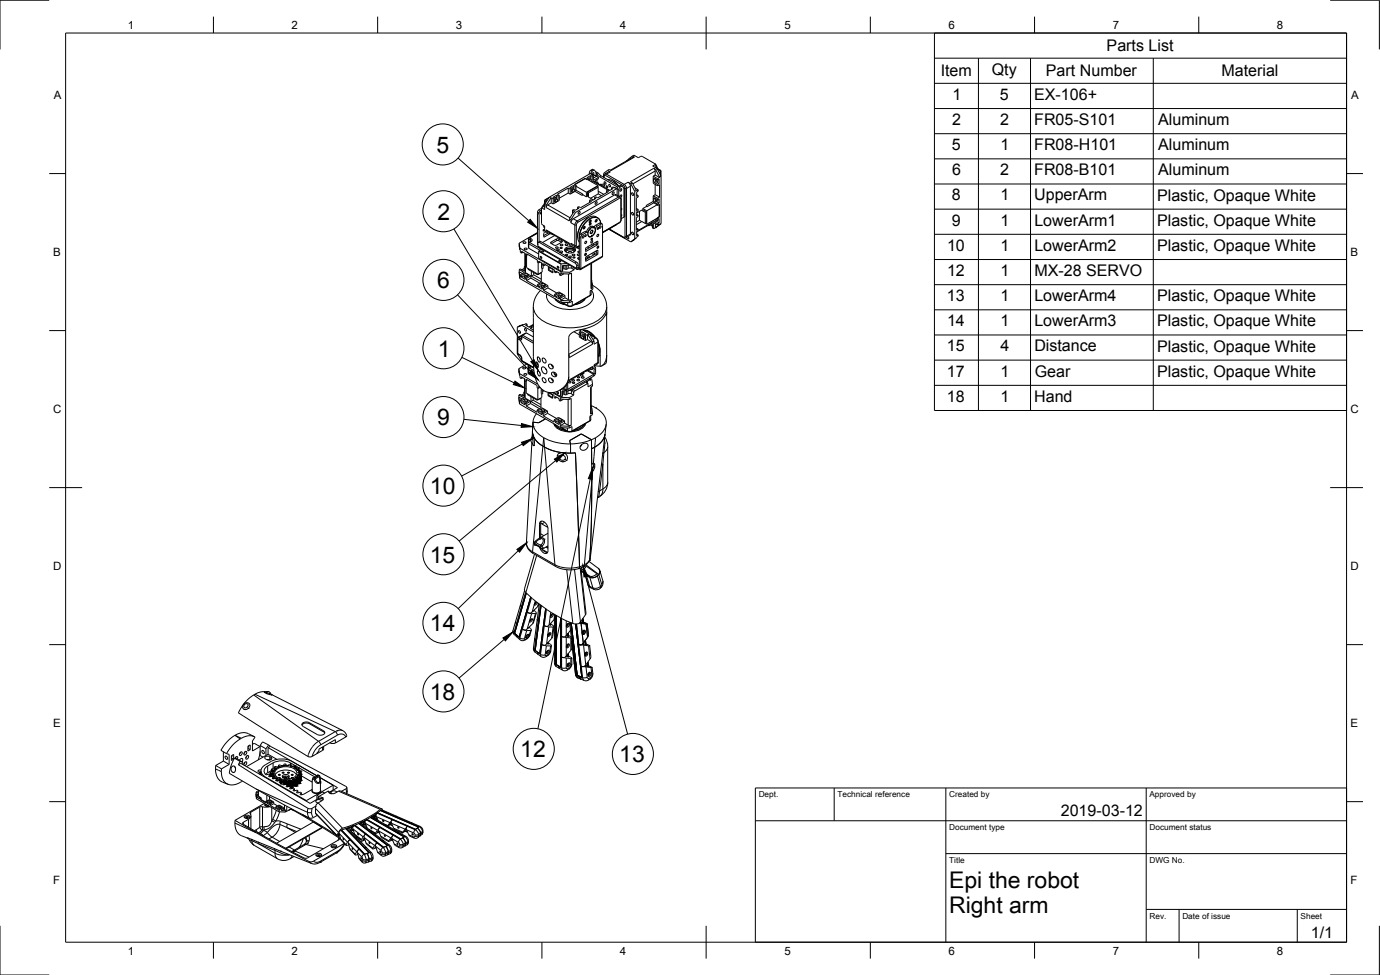
[picture p107: page 1]
8 BCDEF; ABCDEF; Parts List; Item; Qty; Part Number; Material 1; Aluminum 5; Aluminum 6; Aluminum 8; UpperArm; Plastic, Opaque White 9; LowerArm1; Plastic, Opaque White

10 | 1 | LowerArm2 | Plastic, Opaque White
12 | 1 | MX-28 SERVO
13 | 1 | LowerArm4 | Plastic, Opaque White
14 | 1 | LowerArm3 | Plastic, Opaque White
15 | 4 | Distance | Plastic, Opaque White
17 | 1 | Gear | Plastic, Opaque White
18 | 1 | Hand

Dept. | Technical reference | Created by 2019-03-12 | Approved by

Document type | Document status

Title Epi the robot Right arm | DWG No.

Rev. | Date of issue | Sheet 1/1
