birgerjohansson/Epi/Drawings/EpiHead Drawing.pdf

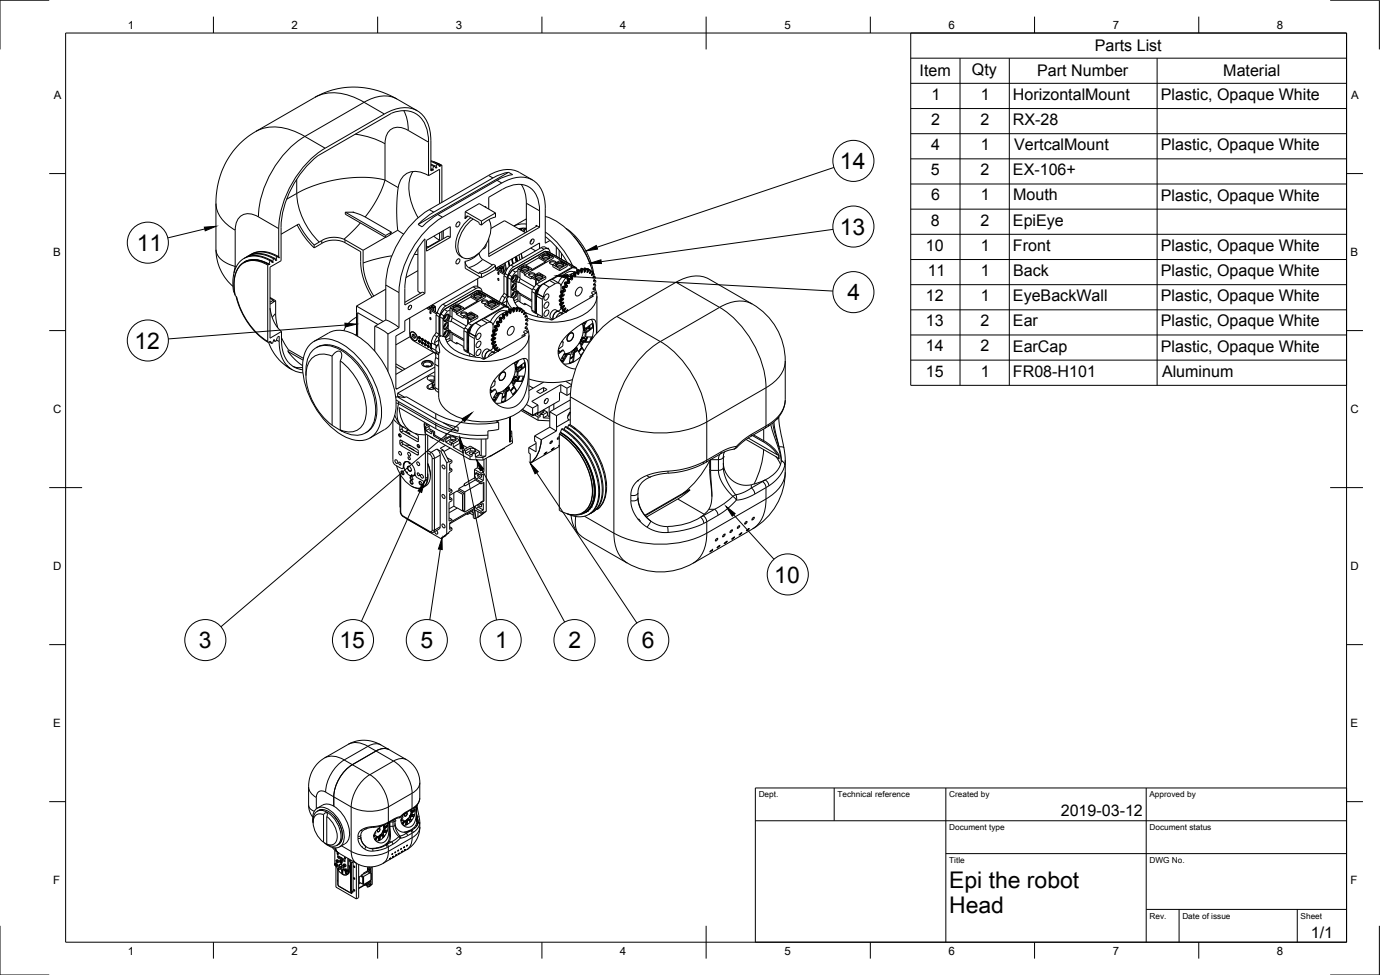
[picture p108: page 1]

Parts List

Item | Qty | Part Number | Material
1 | 1 | HorizontalMount | Plastic, Opaque White
2 | 2 | RX-28
4 | 1 | VertcalMount | Plastic, Opaque White
5 | 2 | EX-106+
6 | 1 | Mouth | Plastic, Opaque White
8 | 2 | EpiEye
10 | 1 | Front | Plastic, Opaque White
11 | 1 | Back | Plastic, Opaque White
12 | 1 | EyeBackWall | Plastic, Opaque White
13 | 2 | Ear | Plastic, Opaque White
14 | 2 | EarCap | Plastic, Opaque White
15 | 1 | FR08-H101 | Aluminum

Dept. | Technical reference | Created by 2019-03-12 | Approved by

Document type | Document status

Title Epi the robot Head | DWG No.

Rev. | Date of issue | Sheet 1/1
