birgerjohansson/Epi/(commit log)

2019-03-13 Adding torso files
    [BackLower.step, BackLower.stl, BackUpper.step, BackUpper.stl, FrontLower.step, FrontLower.stl, FrontUpper.step, FrontUpper.stl]
2019-03-13 Adding Head and Eye files
    [Back.step, Back.stl, BackPlate.step, BackPlate.stl, Ear.step, Ear.stl, EarCap.step, EarCap.stl]
2019-03-13 Adding Arm files
    [Bottom.step, Bottom.stl, EpiFinger.step, EpiFinger.stl, FingerMount.step, FingerMount.stl, Gear.step, Gear.stl]
2022-10-12 Moving models and adding 3d printing models for EpiTorso
    [Back.step, Back.stl, BackLower.step, BackLower.stl, BackPlate.step, BackPlate.stl, BackUpper.step, BackUpper.stl]
2022-10-13 Adding new models for Eye
    [BackPlate.3mf, InnerBody.3mf, IrisBlade.3mf, IrisFront.3mf, IrisGear.3mf, LEDDiffuser.3mf, OuterBody.3mf, ServoGear.3mf]
2022-10-13 Removing not used models
    [BackLower.step, BackLower.stl, BackUpper.step, BackUpper.stl, FrontLower.step, FrontLower.stl, FrontUpper.step, FrontUpper.stl]
2022-11-29 Adding keyring models
    [Epi_singleColorKeyring.3mf, Epi_twoColorKeyringEarInner.3mf, Epi_twoColorKeyringEarOuter.3mf, Epi_twoColorKeyringHead.3mf]
